albinCuriel/LineFollower/parcours/readme.md

# Parcours

Testparcours van de docent. De PDF's zijn op ware grootte: afdrukken en aan elkaar plakken om thuis te testen.

| Bestand | Inhoud |
|---|---|
| [parcours1.pdf](parcours1.pdf) | parcours 1 |
| [parcours2.pdf](parcours2.pdf) | parcours 2 |
| [parcours3.pdf](parcours3.pdf) | parcours 3 |
| [parcours3.svg](parcours3.svg) | parcours 3 als vectorbestand, gebruikt voor de snelheidssimulatie in [onderdelenkeuze.md](../ontwerpkeuzes/onderdelenkeuze.md) |
| [testbaan.pdf](testbaan.pdf) | korte testbaan voor sensor- en PID-testen |

Parcours 3 is ±7,0 m lang (gemeten in de [simulatie](../simulatie/readme.md)) en bestaat grotendeels uit rechte stukken. Alle bochten hebben een straal van ±10 cm.
Volgens de specificaties is de lijn 15 mm breed, rijdt de robot op kruispunten rechtdoor en zijn onderbrekingen korter dan 10 mm.
