albinCuriel/LineFollower/technische tekeningen/elektronisch/kabels/readme.md

# Kabels

Alles wat niet op de gaatjesprint zelf ligt: de batterij-pigtail, de 2 motorkabels (motor + encoder) en de 11 draadjes van de sensor. De gaten (D17, O2, W46, ...) zijn dezelfde als in het [bekabelingsplan](../bekabelingsplan.pdf).

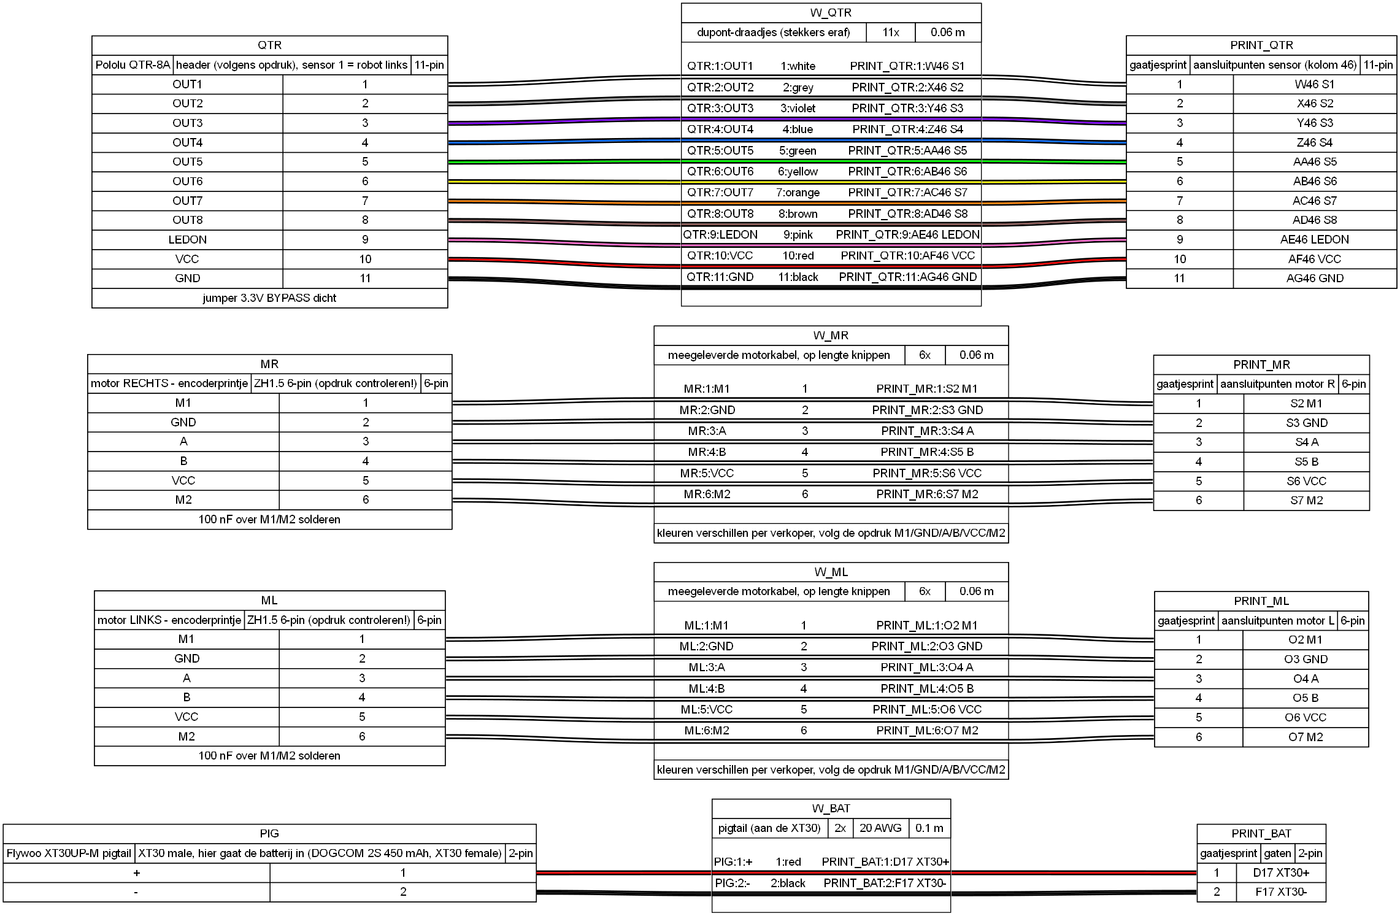
[picture p5: technische tekeningen/elektronisch/kabels/kabels.png]
kabels


| Bestand | Inhoud |
|---|---|
| [kabels.yml](kabels.yml) | beschrijving van de kabels (bron) |
| [kabels.png](kabels.png) / [kabels.svg](kabels.svg) | tekening |
| [kabels.html](kabels.html) | tekening + stuklijst samen |
| [kabels.bom.tsv](kabels.bom.tsv) | stuklijst van de kabels |

Gemaakt met [WireViz](https://github.com/wireviz/WireViz) + [Graphviz](https://graphviz.org):
```
wireviz kabels.yml
```
