albinCuriel/LineFollower/code/basis/basis/readme.md

# basis (sketchmap)

Arduino-sketch van het basisprogramma. Uitleg: [../readme.md](../readme.md).

```
arduino-cli compile --fqbn esp32:esp32:esp32s3 --library ../../lib/lf_core --library ../../lib/lf_esp32 .
```
