albinCuriel/LineFollower/code/finaal/linefollower/readme.md

# linefollower (sketchmap)

Arduino-sketch van de finale firmware. Uitleg en commando's: [../readme.md](../readme.md).

```
arduino-cli compile --fqbn esp32:esp32:esp32s3 --library ../../lib/lf_core --library ../../lib/lf_esp32 .
```
