albinCuriel/LineFollower/technische tekeningen/mechanisch/3d/readme.md

# 3D-model

Gemaakt door [model_linefollower.py](../model_linefollower.py). Assen: X = rijrichting, Y = links, Z = omhoog. Oorsprong = midden wielas op de grond. Eenheid: mm.

| Bestand | Inhoud |
|---|---|
| `linefollower_assembly.step` | volledige samenstelling, te openen in SOLIDWORKS, Fusion 360, FreeCAD of KiCad |
| `*.stl` | elk onderdeel apart. Klik op een STL op GitHub om hem in 3D te bekijken en te draaien |

| STL | Onderdeel |
|---|---|
| [gaatjesprint.stl](gaatjesprint.stl) | chassis 120 × 90 × 1,6 |
| [ESP32-S3_devkit.stl](ESP32-S3_devkit.stl) | ESP32-S3 devkit met pinnen |
| [QTR-8A.stl](QTR-8A.stl) | sensorarray, sensoren naar beneden |
| [M2_bevestiging_sensor.stl](M2_bevestiging_sensor.stl) | 2× M2×25 voor de sensorhoogte |
| [TB6612FNG.stl](TB6612FNG.stl) | H-brug |
| [buck_CN3903_3V3.stl](buck_CN3903_3V3.stl) | 3,3 V-regelaar |
| [LiPo_2S_450mAh.stl](LiPo_2S_450mAh.stl) | batterij |
| [XT30.stl](XT30.stl) | batterijconnector |
| [motor_links.stl](motor_links.stl), [motor_rechts.stl](motor_rechts.stl) | N20 10:1 met encoder |
| [beugel_links.stl](beugel_links.stl), [beugel_rechts.stl](beugel_rechts.stl) | Pololu motorbeugels |
| [wiel_links.stl](wiel_links.stl), [wiel_rechts.stl](wiel_rechts.stl) | Pololu wiel 32×7 |
| [ball_caster.stl](ball_caster.stl) | Pololu ball caster 3/8″ |
| [caster_afstandsstukken.stl](caster_afstandsstukken.stl) | afstandsringen + moeren tot 12,4 mm |
| [aan_uit_schakelaar.stl](aan_uit_schakelaar.stl) | SS12D00 |
| [start_stop_knop.stl](start_stop_knop.stl) | drukknop 6×6 |
| [elco_100uF.stl](elco_100uF.stl) | C1 en C2 |
| [spoiler.stl](spoiler.stl), [spoiler_bouten.stl](spoiler_bouten.stl) | spoiler uit het afgezaagde stuk print, op 2× M3×30 |

Niets wordt 3D-geprint. Het model dient om te controleren of alles past en om de tekeningen te maken.
