albinCuriel/LineFollower/code/proof of concepts/hbridge/poc_hbridge/readme.md

# poc_hbridge

Arduino-sketchmap. Open `poc_hbridge.ino` in de Arduino IDE of compileer met

```
arduino-cli compile --fqbn esp32:esp32:esp32s3 .
```

`board.h` is een kopie van [code/board.h](../../../board.h) (Arduino neemt enkel bestanden uit de eigen sketchmap mee).
Uitleg en testresultaat: [readme van deze proof of concept](../readme.md).
