albinCuriel/LineFollower/images/readme.md

# Images

Foto's van de robot tijdens en na de bouw. Ze komen hier zodra de onderdelen geleverd en gemonteerd zijn.

| Bestand | Inhoud |
|---|---|
| `empty.png` | plaatshouder uit de template |

De renders van het 3D-model staan in [technische tekeningen/mechanisch](../technische%20tekeningen/mechanisch/readme.md).
