albinCuriel/LineFollower/technische tekeningen/elektronisch/bekabelingsplan_boormal_1op1.png

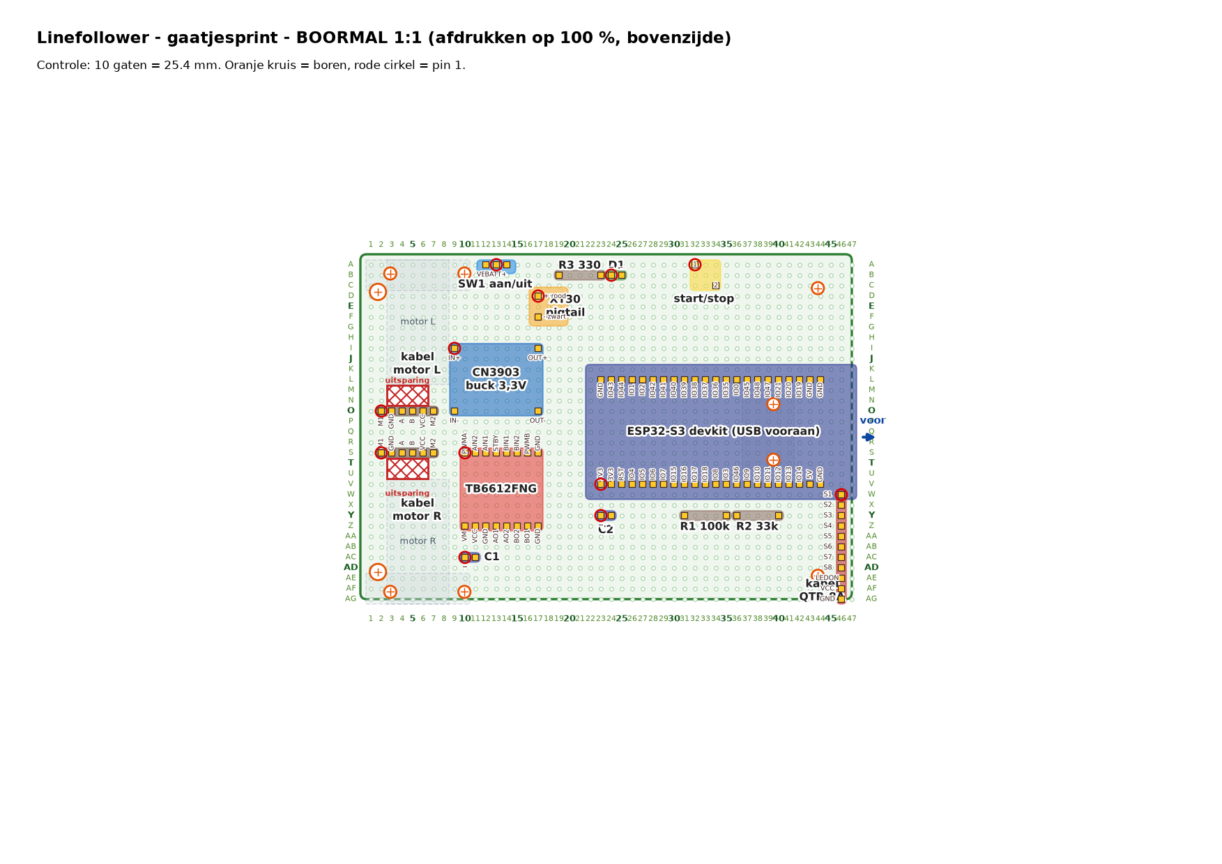
technische tekeningen/elektronisch/bekabelingsplan_boormal_1op1.png
