albinCuriel/LineFollower/technische tekeningen/elektronisch/bekabelingsplan_p08_alles.png

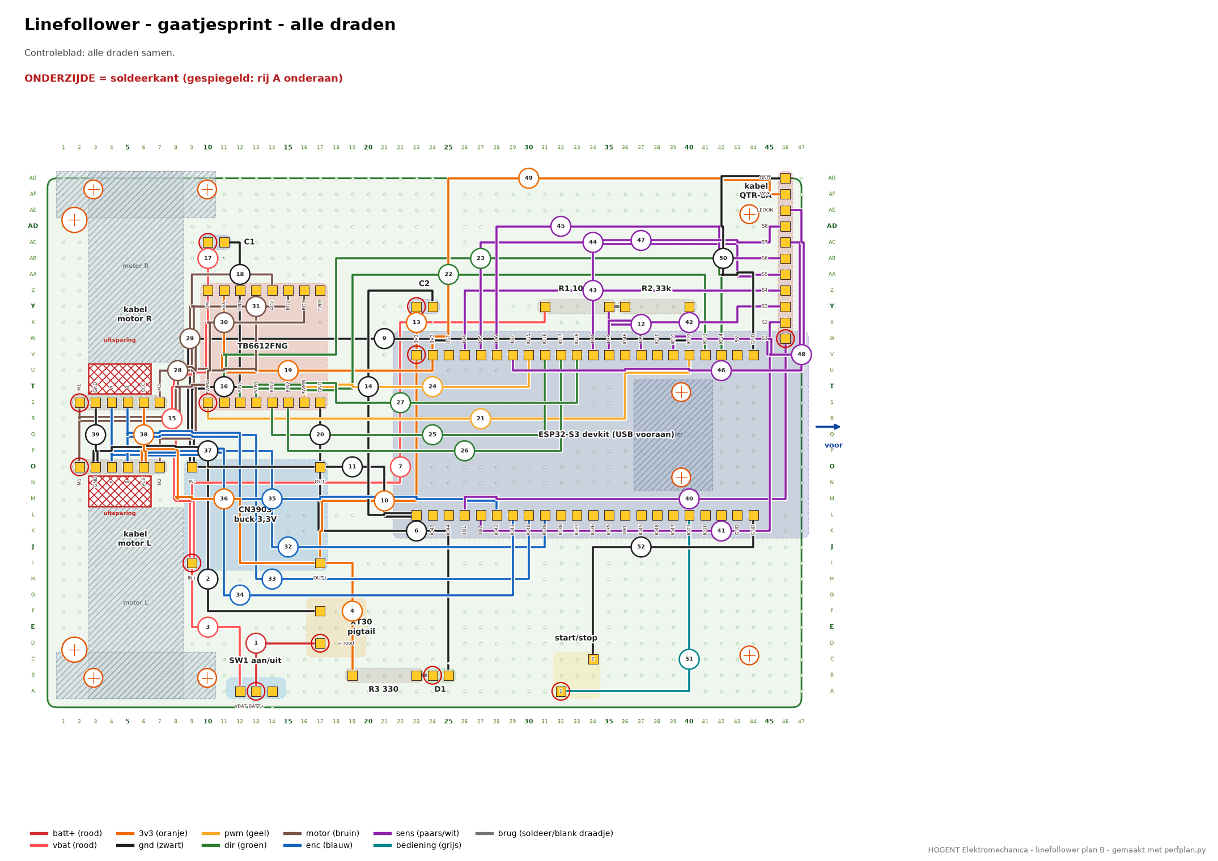
technische tekeningen/elektronisch/bekabelingsplan_p08_alles.png
