albinCuriel/LineFollower/technische tekeningen/mechanisch/3d_iso_achter_rechts.png

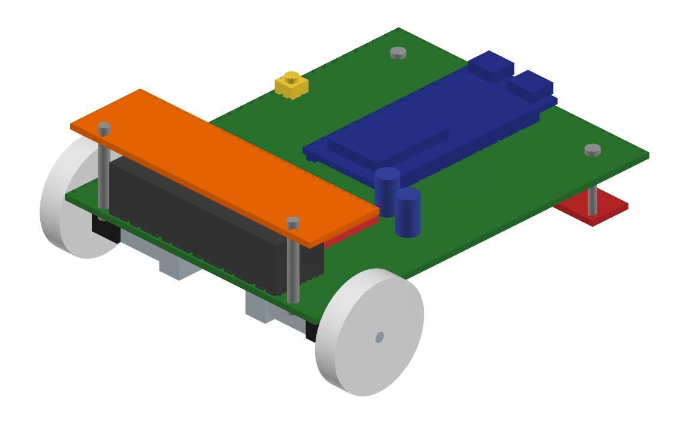
technische tekeningen/mechanisch/3d_iso_achter_rechts.png
