albinCuriel/LineFollower/technische tekeningen/mechanisch/3d_iso_onder.png

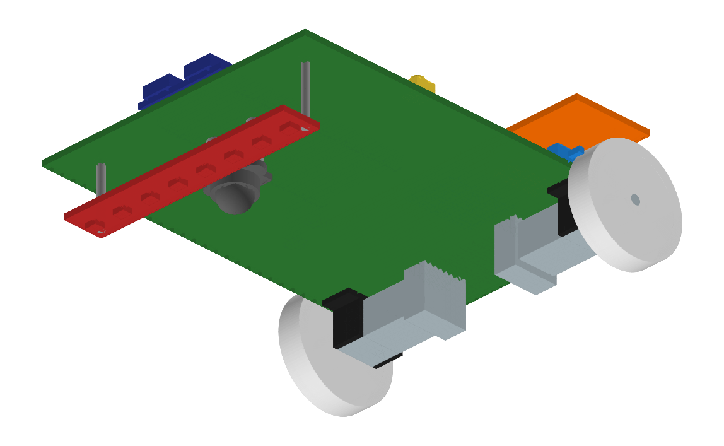
technische tekeningen/mechanisch/3d_iso_onder.png
