albinCuriel/LineFollower/technische tekeningen/mechanisch/3d/linefollower_assembly.step

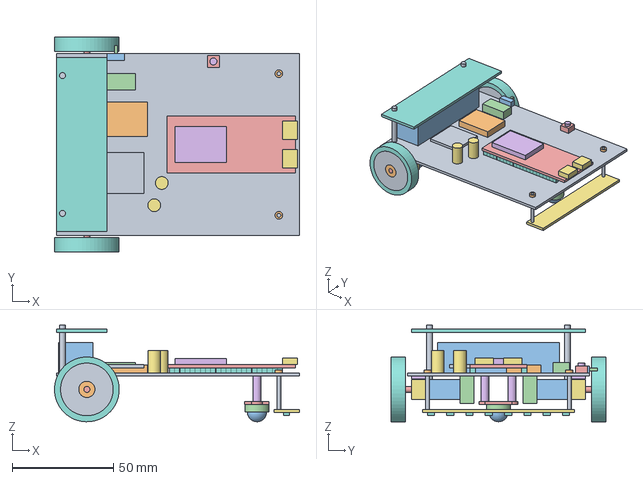
[picture p16: CAD file, 2026-10-19]
technische tekeningen/mechanisch/3d/linefollower_assembly.step
121.0 x 106.0 x 47.7 mm
