albinCuriel/LineFollower/technische tekeningen/mechanisch/3d/caster_afstandsstukken.stl

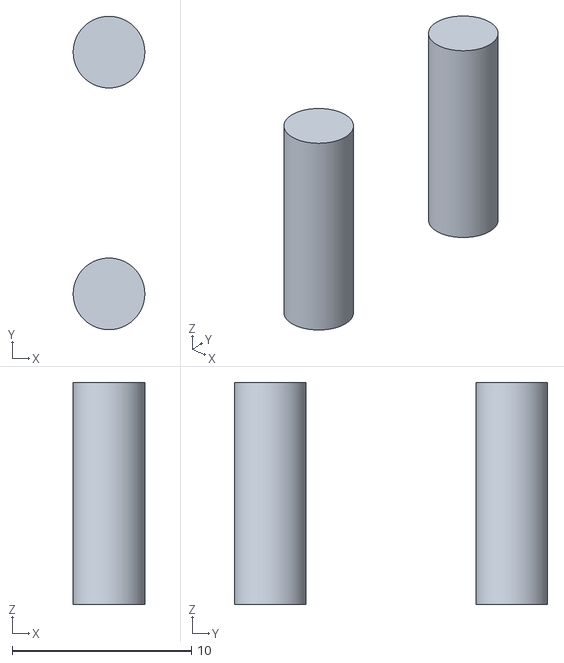
[picture p17: CAD file, 2026-10-19]
technische tekeningen/mechanisch/3d/caster_afstandsstukken.stl
4.00 x 17.5 x 12.4
