albinCuriel/LineFollower/technische tekeningen/mechanisch/3d/ball_caster.stl

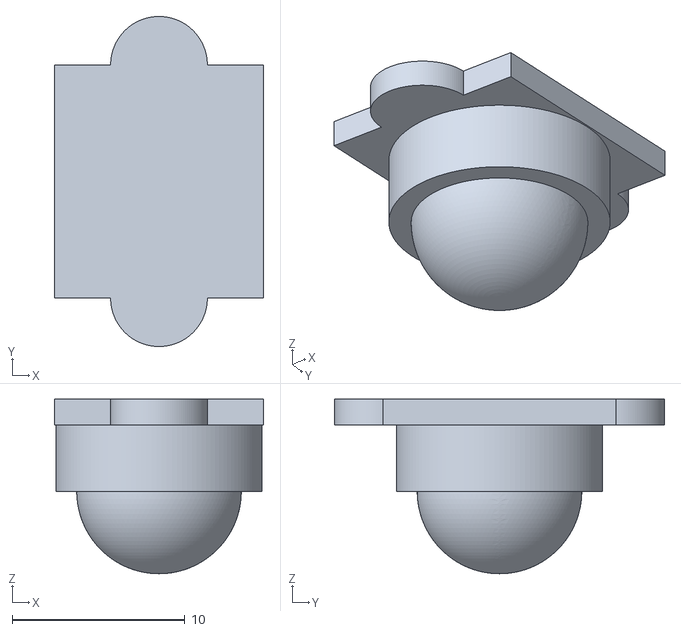
[picture p18: CAD file, 2026-10-19]
technische tekeningen/mechanisch/3d/ball_caster.stl
12.1 x 19.1 x 10.1
