albinCuriel/LineFollower/technische tekeningen/mechanisch/3d/aan_uit_schakelaar.stl

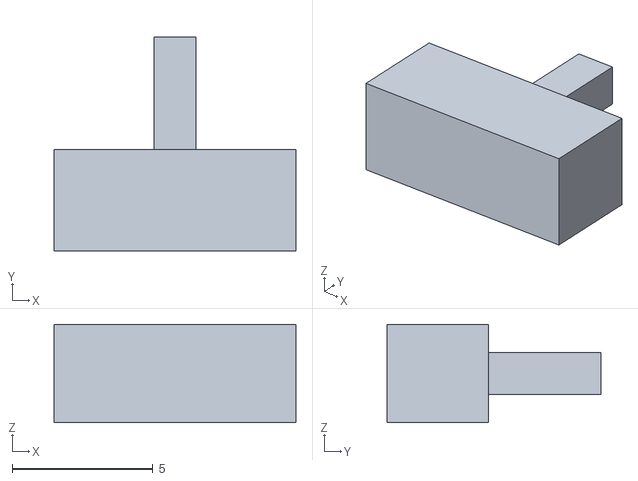
[picture p19: CAD file, 2026-10-19]
technische tekeningen/mechanisch/3d/aan_uit_schakelaar.stl
8.60 x 7.60 x 3.50
