albinCuriel/LineFollower/technische tekeningen/mechanisch/3d/gaatjesprint.stl

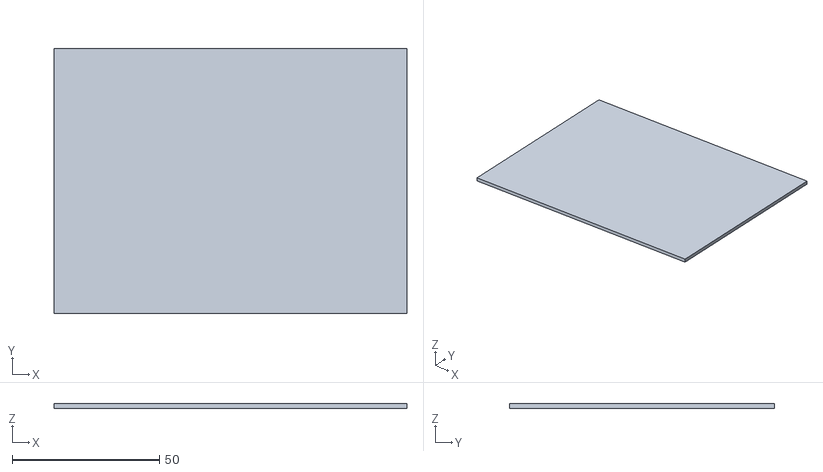
[picture p20: CAD file, 2026-10-19]
technische tekeningen/mechanisch/3d/gaatjesprint.stl
120.0 x 90.0 x 1.60
