albinCuriel/LineFollower/technische tekeningen/mechanisch/3d/spoiler_bouten.stl

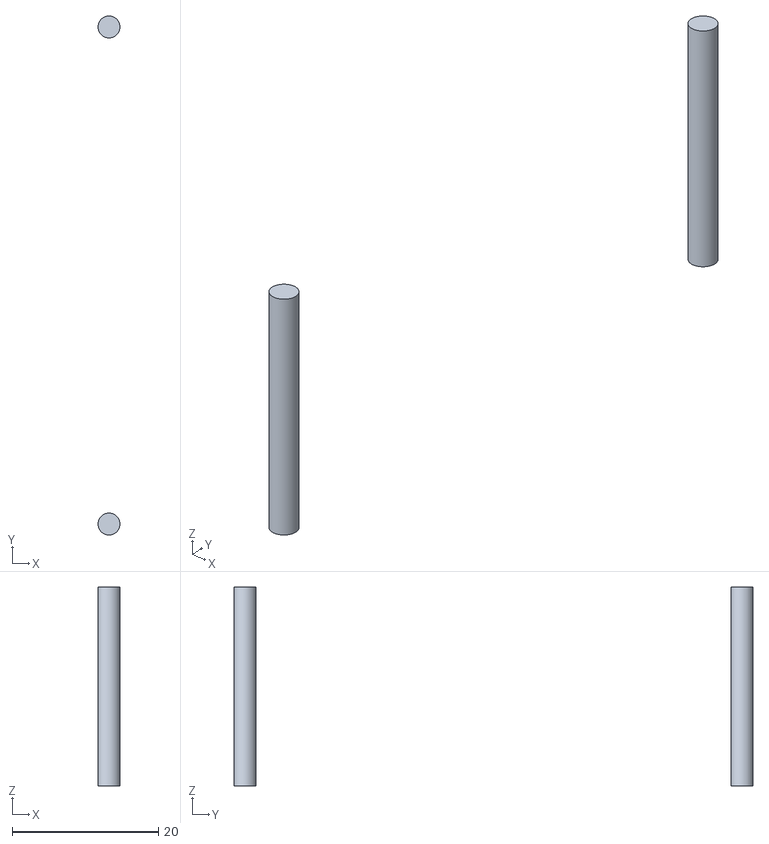
[picture p21: CAD file, 2026-10-19]
technische tekeningen/mechanisch/3d/spoiler_bouten.stl
3.00 x 71.0 x 27.2
