albinCuriel/LineFollower/technische tekeningen/mechanisch/3d/motor_links.stl

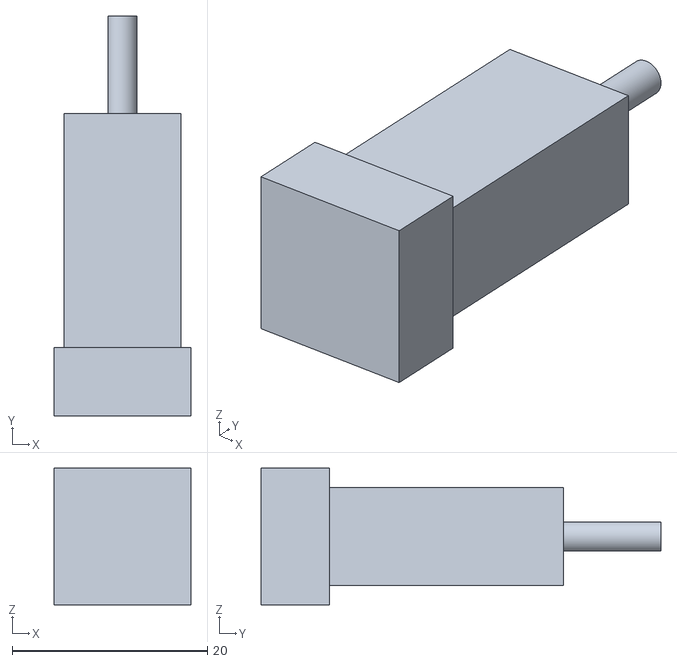
[picture p22: CAD file, 2026-10-19]
technische tekeningen/mechanisch/3d/motor_links.stl
14.0 x 41.0 x 14.0
