albinCuriel/LineFollower/technische tekeningen/mechanisch/3d/ESP32-S3_devkit.stl

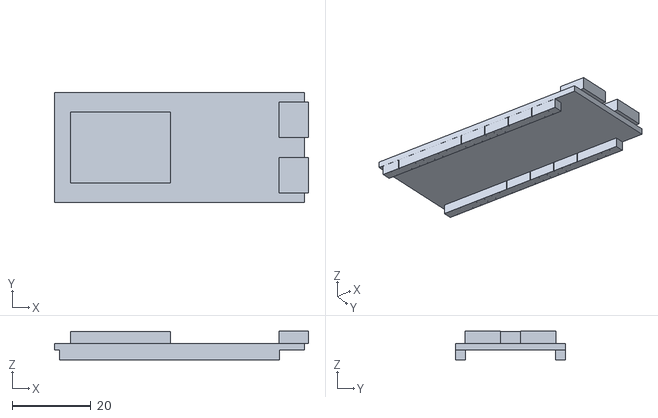
[picture p23: CAD file, 2026-10-19]
technische tekeningen/mechanisch/3d/ESP32-S3_devkit.stl
64.5 x 28.0 x 7.30
