albinCuriel/LineFollower/technische tekeningen/mechanisch/3d/LiPo_2S_450mAh.stl

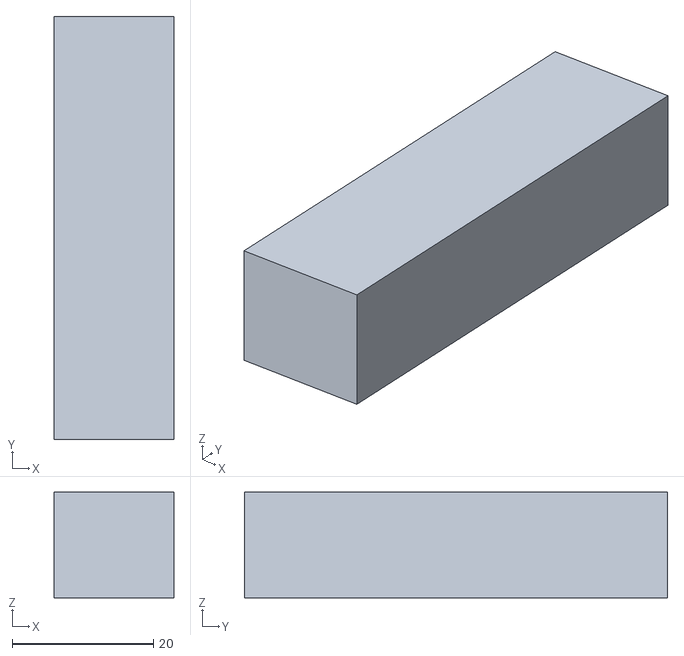
[picture p24: CAD file, 2026-10-19]
technische tekeningen/mechanisch/3d/LiPo_2S_450mAh.stl
17.0 x 60.0 x 15.0
