albinCuriel/LineFollower/technische tekeningen/mechanisch/3d/beugel_links.stl

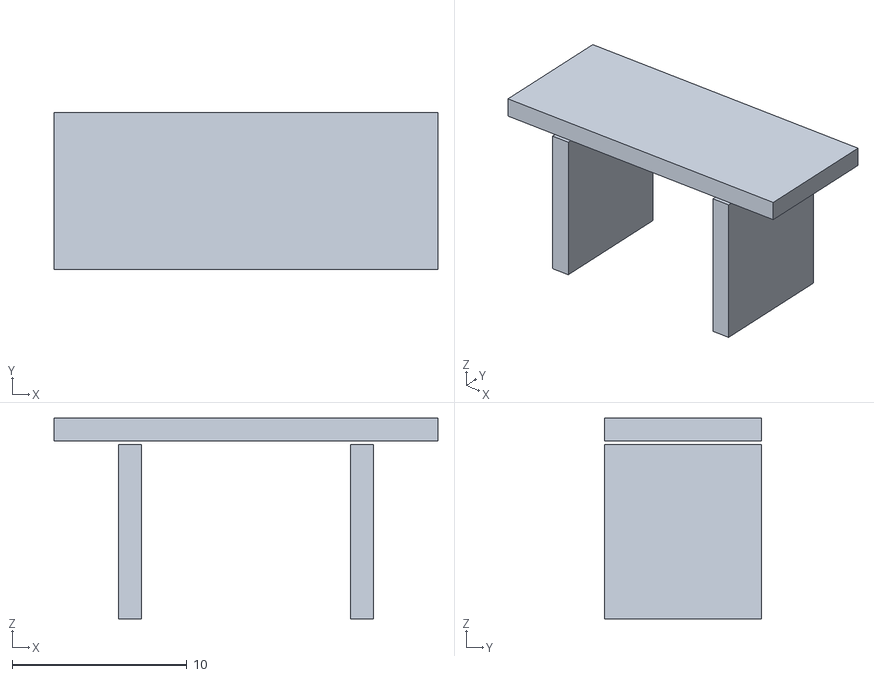
[picture p25: CAD file, 2026-10-19]
technische tekeningen/mechanisch/3d/beugel_links.stl
22.0 x 9.00 x 11.5
