albinCuriel/LineFollower/technische tekeningen/mechanisch/3d/spoiler.stl

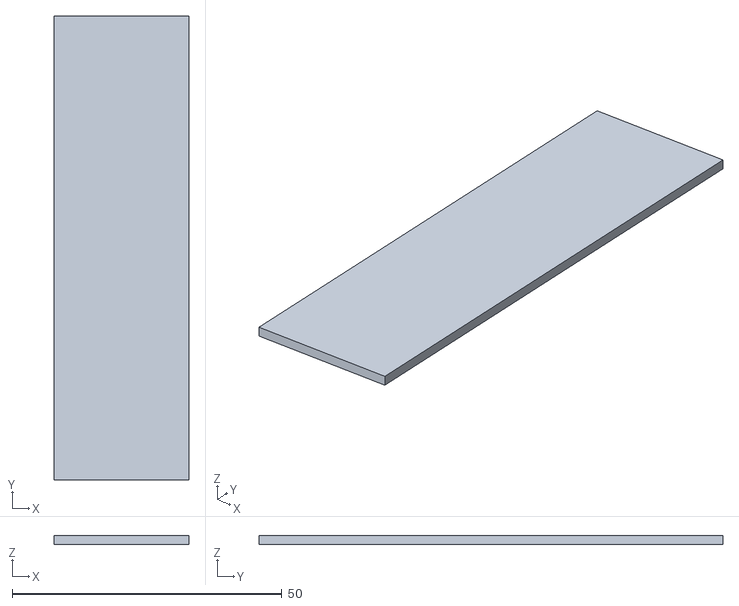
[picture p26: CAD file, 2026-10-19]
technische tekeningen/mechanisch/3d/spoiler.stl
25.0 x 86.0 x 1.60
