albinCuriel/LineFollower/technische tekeningen/mechanisch/3d/wiel_links.stl

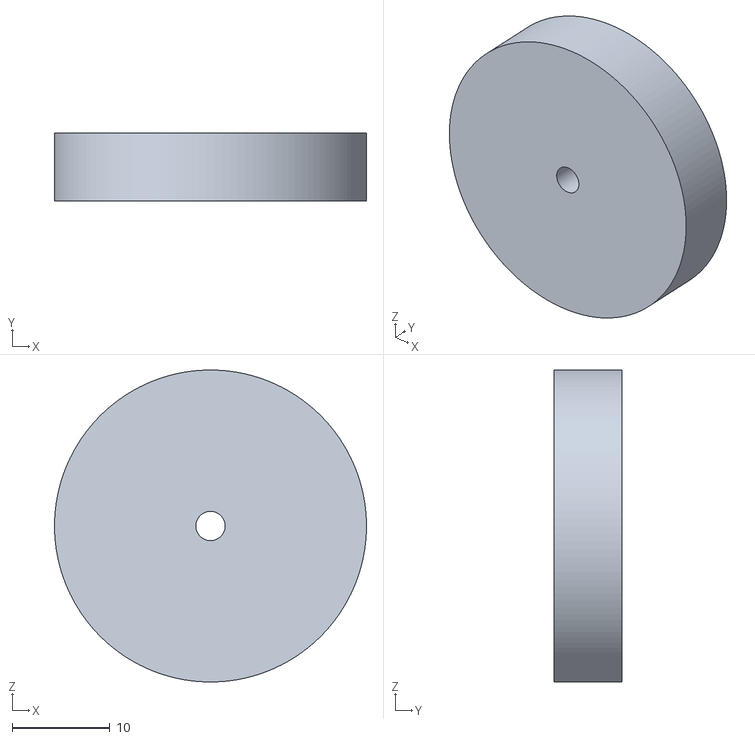
[picture p27: CAD file, 2026-10-19]
technische tekeningen/mechanisch/3d/wiel_links.stl
32.0 x 7.00 x 32.0
