albinCuriel/LineFollower/technische tekeningen/mechanisch/3d/QTR-8A.stl

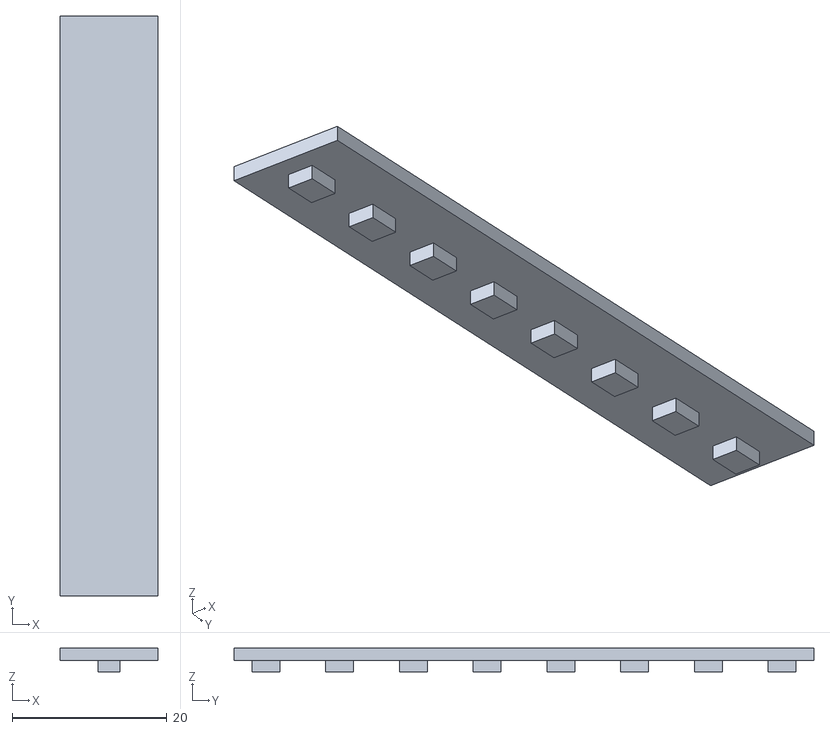
[picture p28: CAD file, 2026-10-19]
technische tekeningen/mechanisch/3d/QTR-8A.stl
12.7 x 74.9 x 3.07
