albinCuriel/LineFollower/technische tekeningen/mechanisch/3d/start_stop_knop.stl

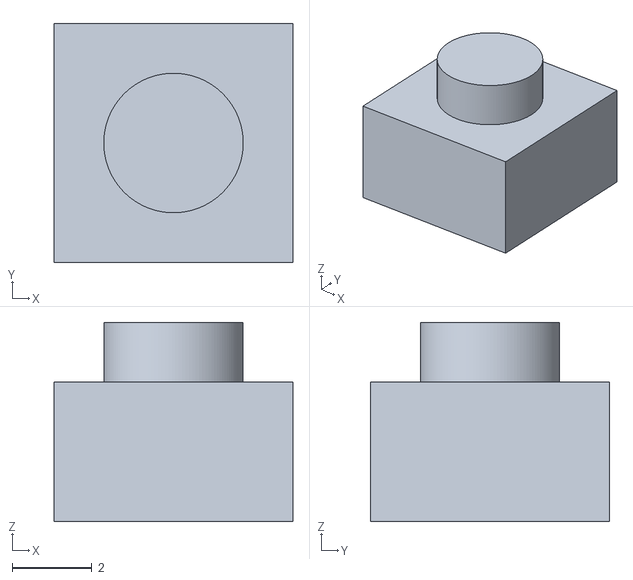
[picture p29: CAD file, 2026-10-19]
technische tekeningen/mechanisch/3d/start_stop_knop.stl
6.00 x 6.00 x 5.00
