albinCuriel/LineFollower/technische tekeningen/mechanisch/3d/M2_bevestiging_sensor.stl

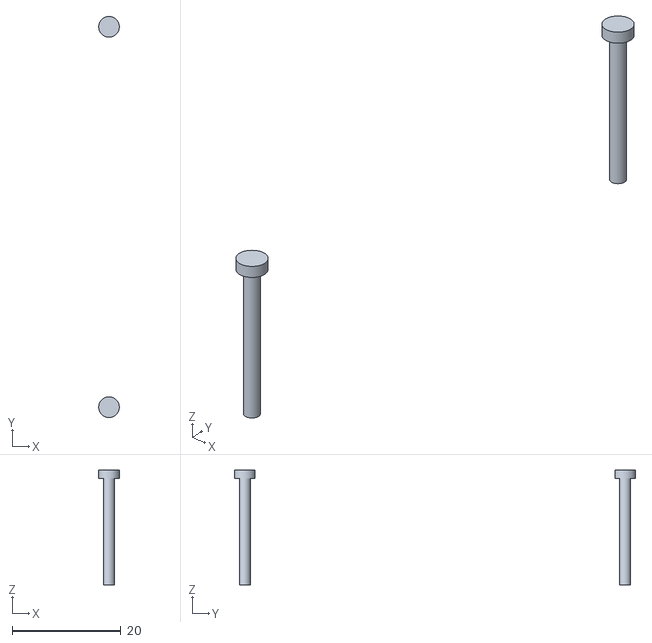
[picture p30: CAD file, 2026-10-19]
technische tekeningen/mechanisch/3d/M2_bevestiging_sensor.stl
3.80 x 73.7 x 21.1
