albinCuriel/LineFollower/technische tekeningen/mechanisch/3d/TB6612FNG.stl

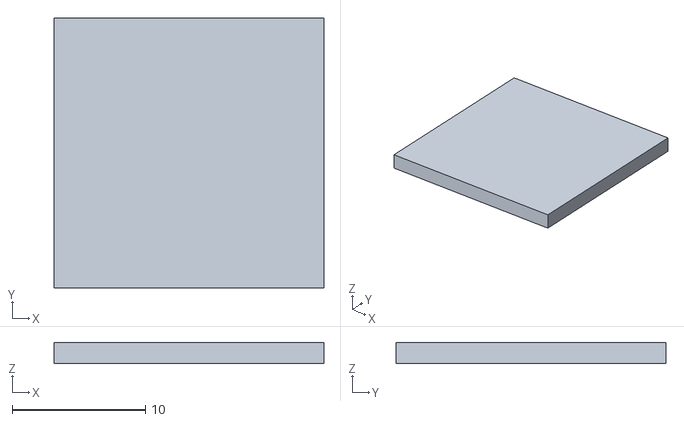
[picture p31: CAD file, 2026-10-19]
technische tekeningen/mechanisch/3d/TB6612FNG.stl
20.3 x 20.3 x 1.60
