albinCuriel/LineFollower/technische tekeningen/mechanisch/3d/XT30.stl

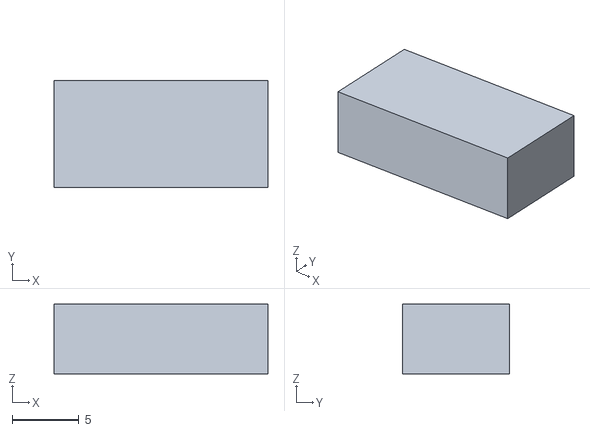
[picture p32: CAD file, 2026-10-19]
technische tekeningen/mechanisch/3d/XT30.stl
16.0 x 8.00 x 5.20
