albinCuriel/LineFollower/technische tekeningen/mechanisch/3d/buck_CN3903_3V3.stl

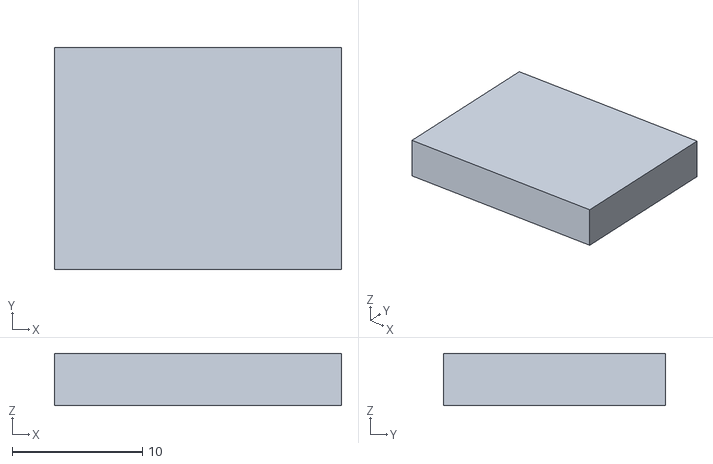
[picture p33: CAD file, 2026-10-19]
technische tekeningen/mechanisch/3d/buck_CN3903_3V3.stl
22.0 x 17.0 x 4.00
