albinCuriel/LineFollower/technische tekeningen/mechanisch/3d/elco_100uF.stl

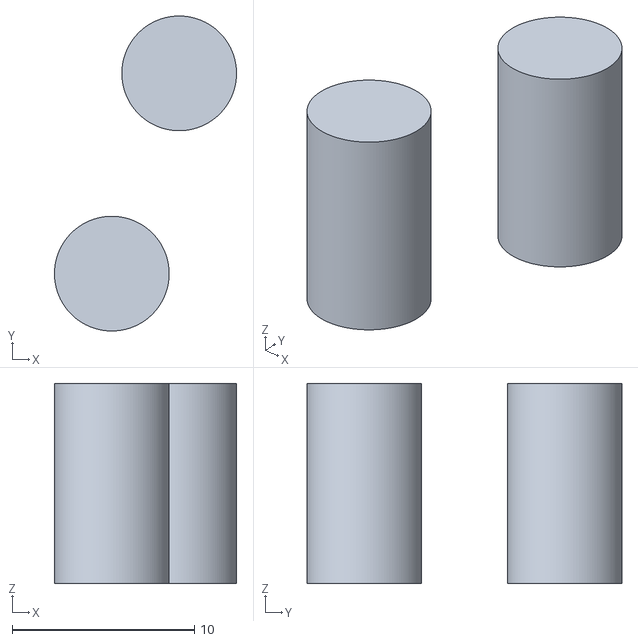
[picture p34: CAD file, 2026-10-19]
technische tekeningen/mechanisch/3d/elco_100uF.stl
10.0 x 17.3 x 11.0
