albinCuriel/LineFollower/(list of files, cad)

Other CAD files:
technische tekeningen/mechanisch/3d/motor_rechts.stl
technische tekeningen/mechanisch/3d/wiel_rechts.stl
technische tekeningen/mechanisch/3d/beugel_rechts.stl
