albinCuriel/LineFollower/simulatie/resultaat.png

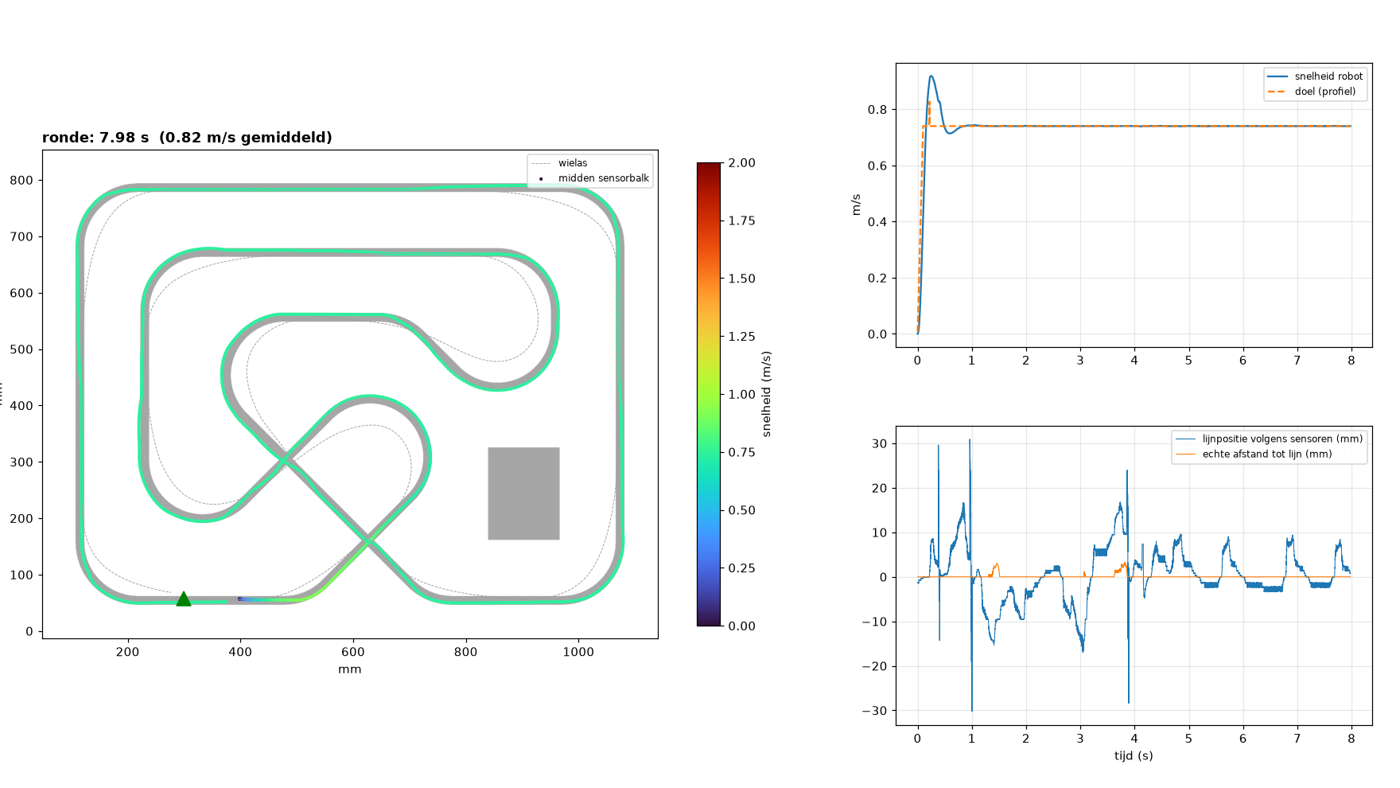
simulatie/resultaat.png
