albinCuriel/LineFollower/technische tekeningen/elektronisch/bekabelingsplan.pdf

## Onderdeel · referentiepin -> gat

# Linefollower - gaatjesprint - plaatsing

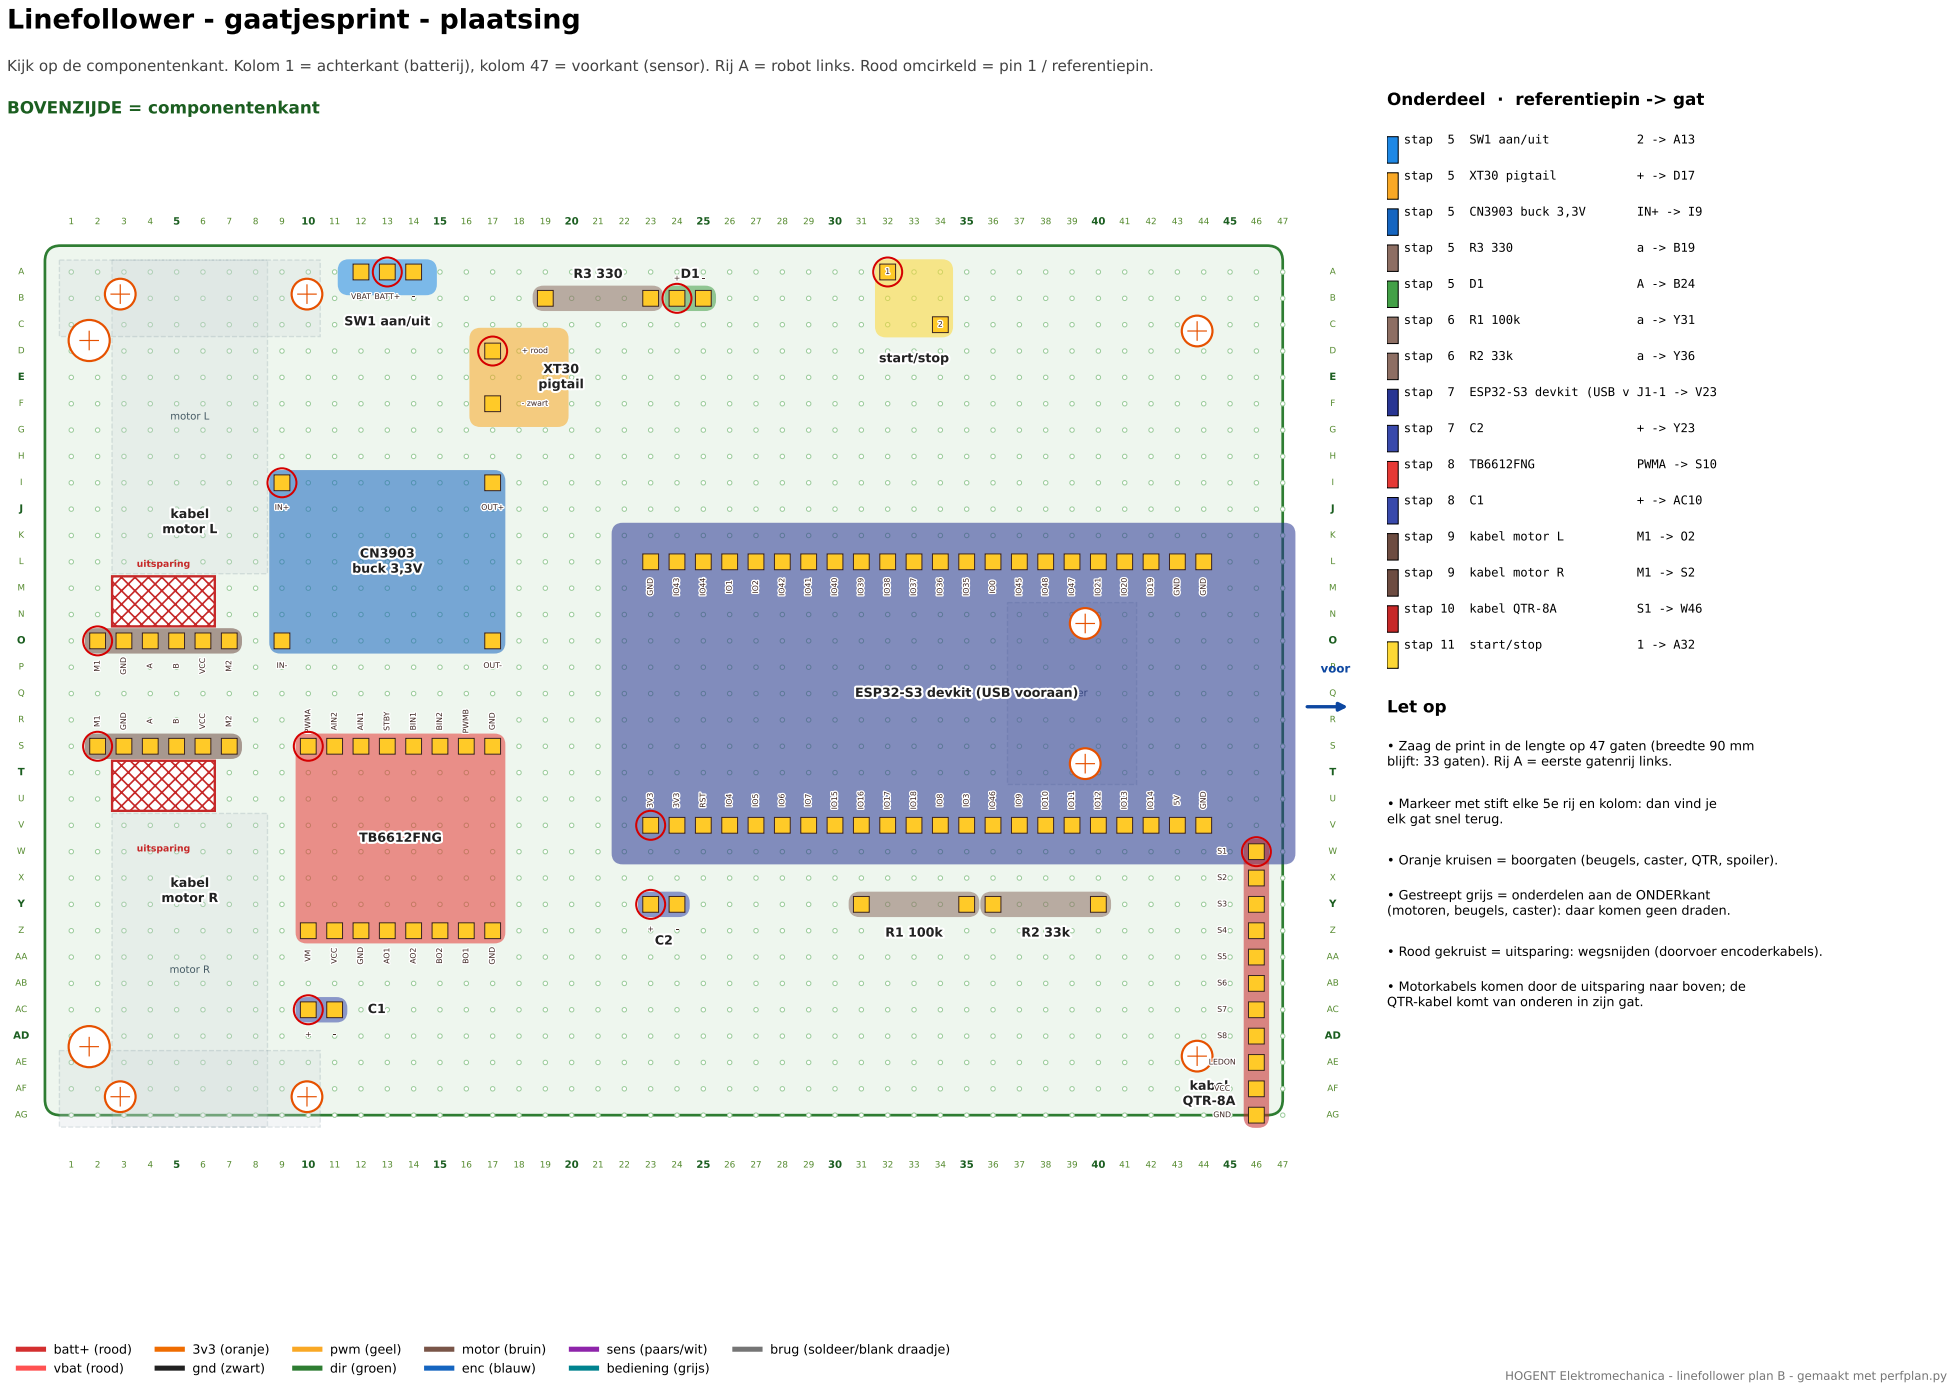
[picture p37: page 1]

Kijk op de componentenkant. Kolom 1 = achterkant (batterij), kolom 47 = voorkant (sensor). Rij A = robot links. Rood omcirkeld = pin 1 / referentiepin.

• Zaag de print in de lengte op 47 gaten (breedte 90 mm
blijft: 33 gaten). Rij A = eerste gatenrij links.

• Markeer met stift elke 5e rij en kolom: dan vind je
elk gat snel terug.

• Oranje kruisen = boorgaten (beugels, caster, QTR, spoiler).

• Gestreept grijs = onderdelen aan de ONDERkant
(motoren, beugels, caster): daar komen geen draden.

• Rood gekruist = uitsparing: wegsnijden (doorvoer encoderkabels).

• Motorkabels komen door de uitsparing naar boven; de
QTR-kabel komt van onderen in zijn gat.

brug (soldeer/blank draadje)

HOGENT Elektromechanica - linefollower plan B - gemaakt met perfplan.py

## Draden stap 5 (nr gat pin / gat pin lengte)

# Stap 5 - voeding

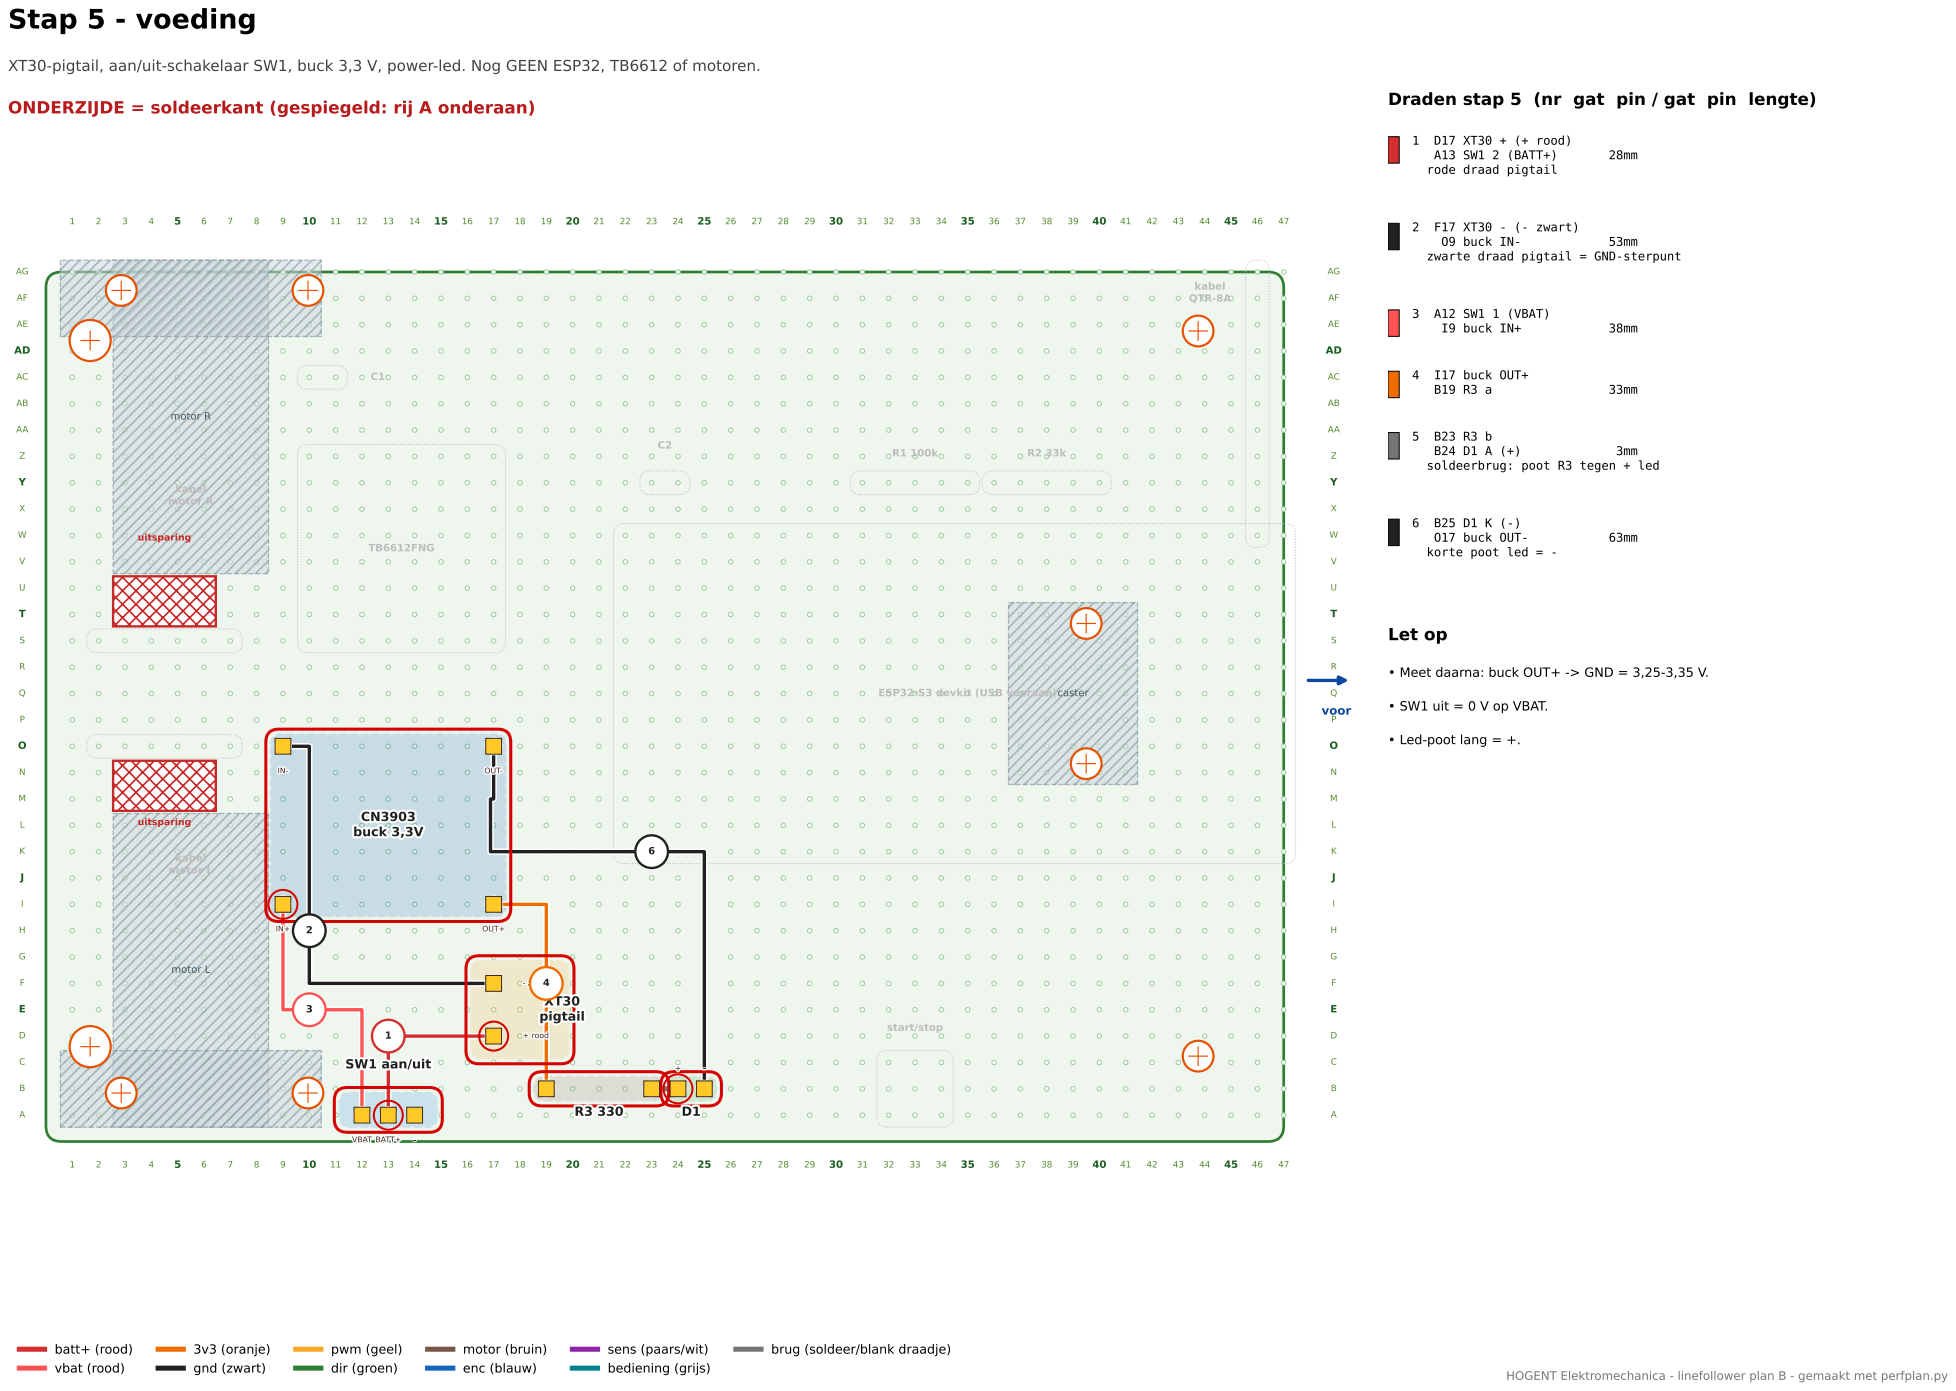
[picture p38: page 2]

XT30-pigtail, aan/uit-schakelaar SW1, buck 3,3 V, power-led. Nog GEEN ESP32, TB6612 of motoren.

ONDERZIJDE = soldeerkant (gespiegeld: rij A onderaan)

zwarte draad pigtail = GND-sterpunt

soldeerbrug: poot R3 tegen + led

• Meet daarna: buck OUT+ -> GND = 3,25-3,35 V.

## Draden stap 6 (nr gat pin / gat pin lengte)

# Stap 6 - batterijmeting

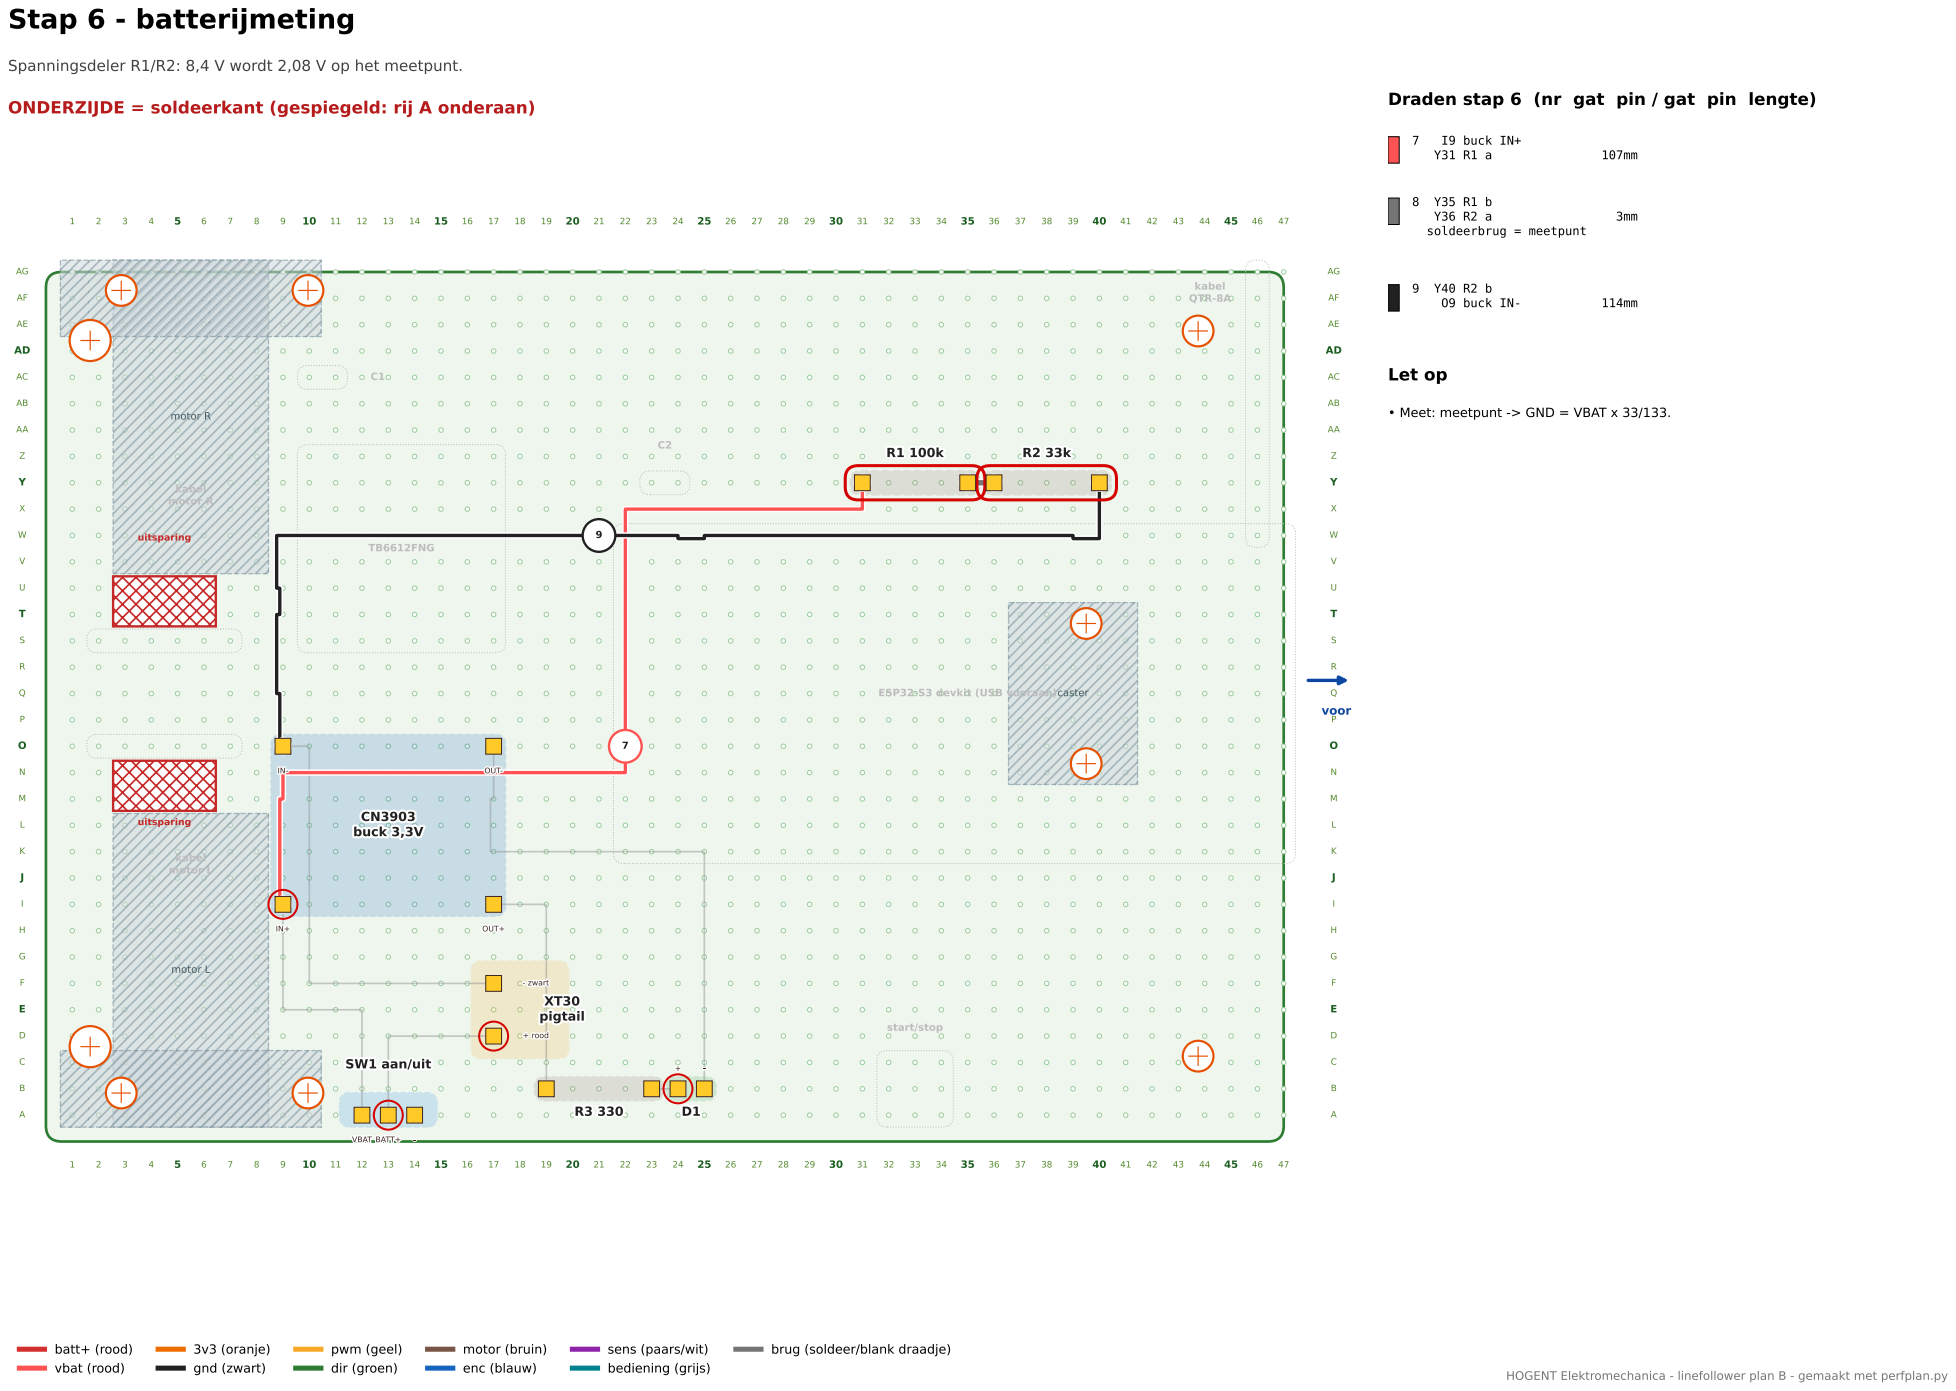
[picture p39: page 3]
motor L; motor R; caster; voor; uitsparing; TB6612FNG; kabel motor L; kabel motor R; kabel QTR-8A; start/stop; I9 buck IN+; soldeerbrug = meetpunt; O9 buck IN-; Let op

Spanningsdeler R1/R2: 8,4 V wordt 2,08 V op het meetpunt.

ONDERZIJDE = soldeerkant (gespiegeld: rij A onderaan)

• Meet: meetpunt -> GND = VBAT x 33/133.

ESP32-S3 devkit (USB vooraan)

## Draden stap 7 (nr gat pin / gat pin lengte)

# Stap 7 - ESP32-S3 devkit

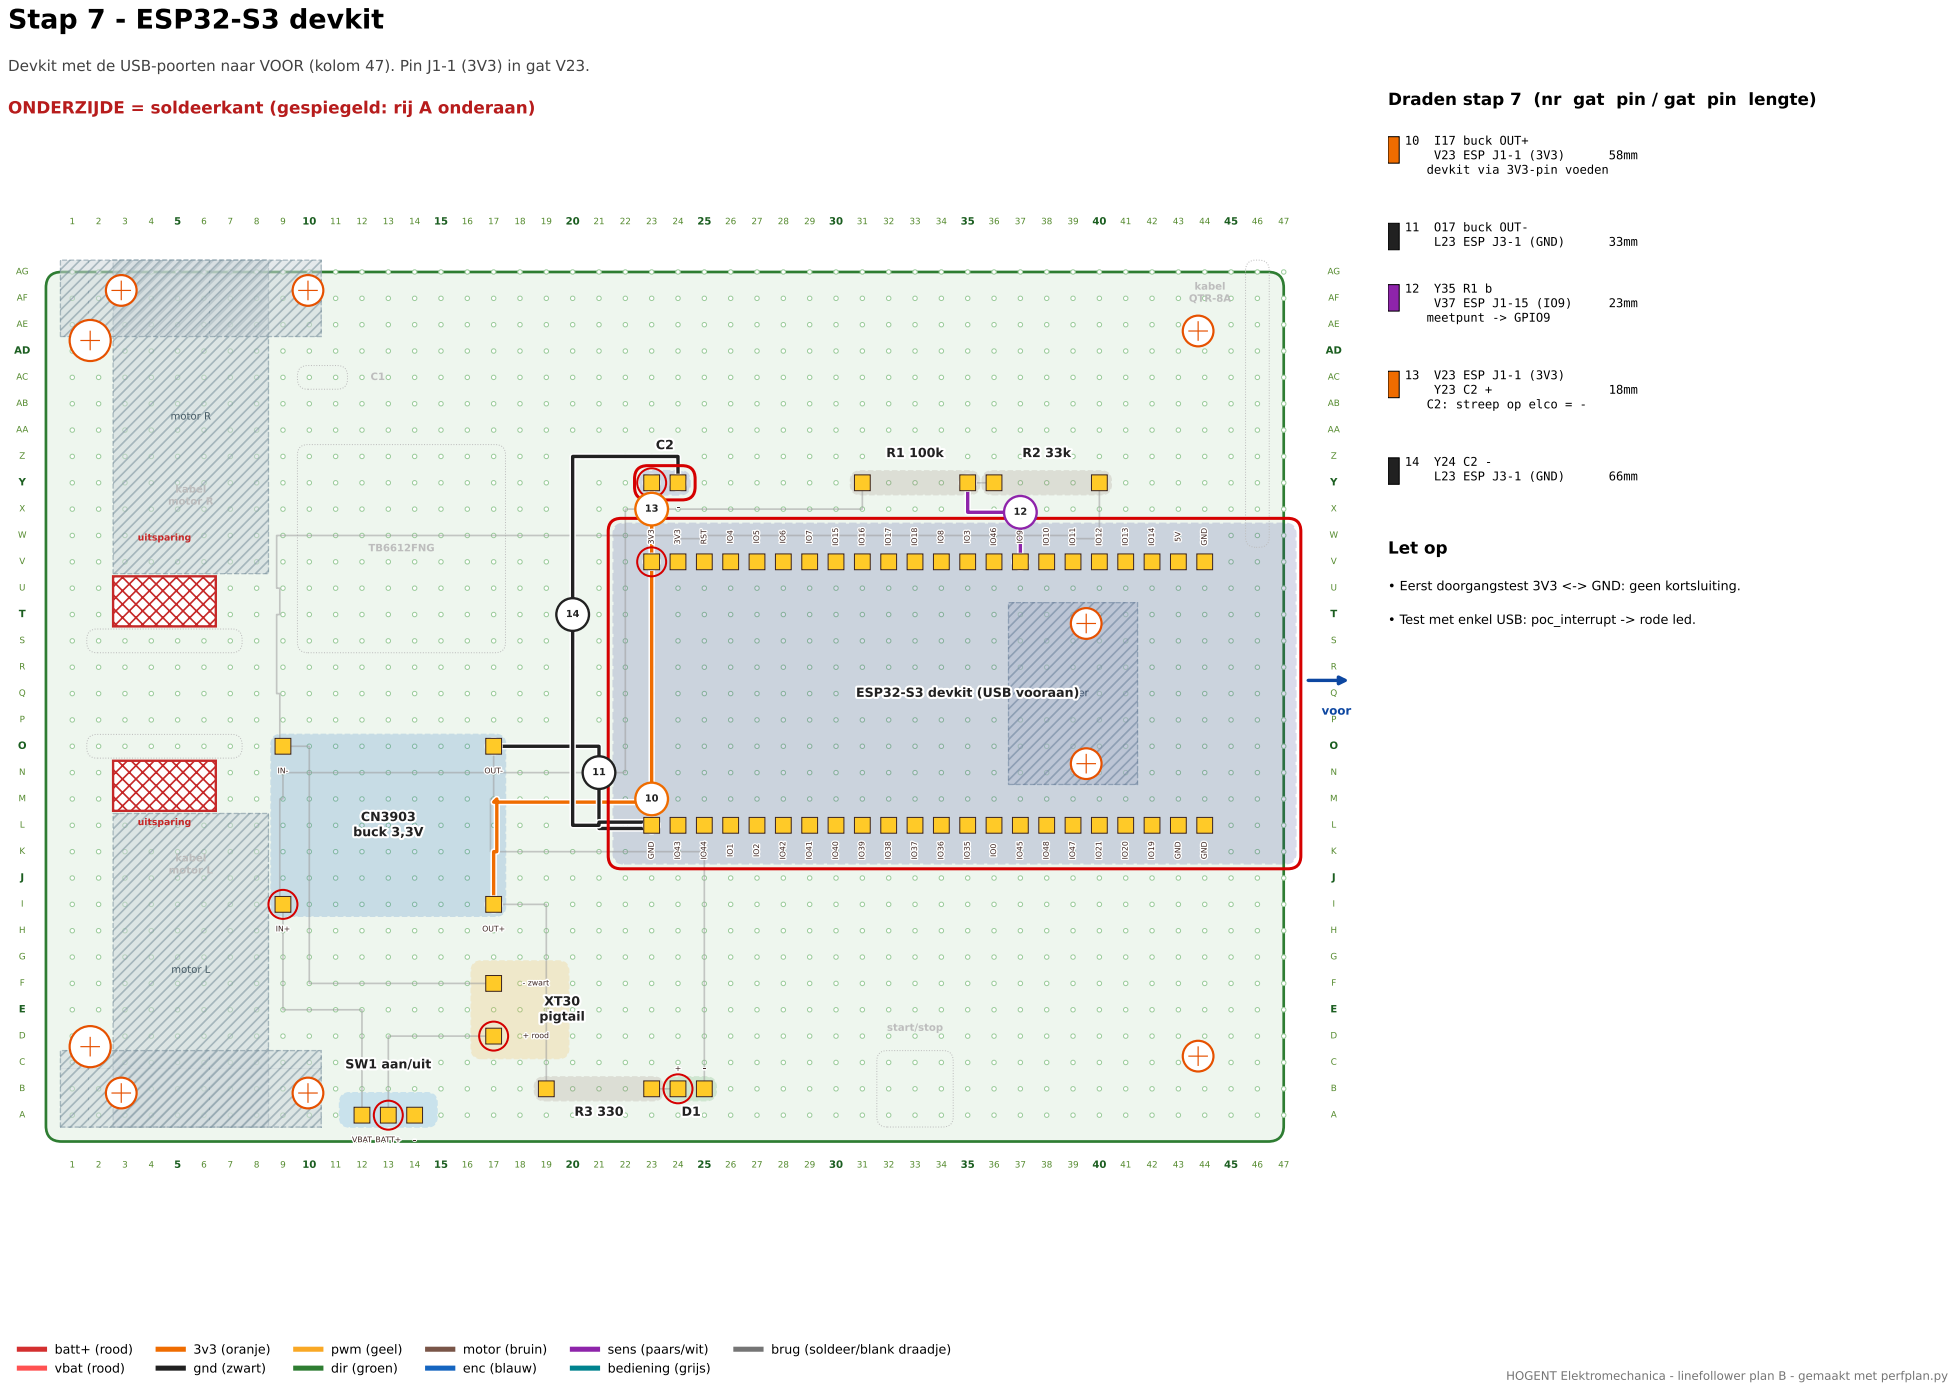
[picture p40: page 4]
motor L; motor R; caster; voor; uitsparing; TB6612FNG; kabel motor L; kabel motor R; kabel QTR-8A; start/stop; I17 buck OUT+; V23 ESP J1-1 (3V3); O17 buck OUT-; L23 ESP J3-1 (GND); V37 ESP J1-15 (IO9); meetpunt -> GPIO9; Let op

Devkit met de USB-poorten naar VOOR (kolom 47). Pin J1-1 (3V3) in gat V23.

ONDERZIJDE = soldeerkant (gespiegeld: rij A onderaan)

devkit via 3V3-pin voeden

C2: streep op elco = -

• Eerst doorgangstest 3V3 <-> GND: geen kortsluiting.

• Test met enkel USB: poc_interrupt -> rode led.

## Draden stap 8 (nr gat pin / gat pin lengte)

# Stap 8 - H-brug TB6612FNG

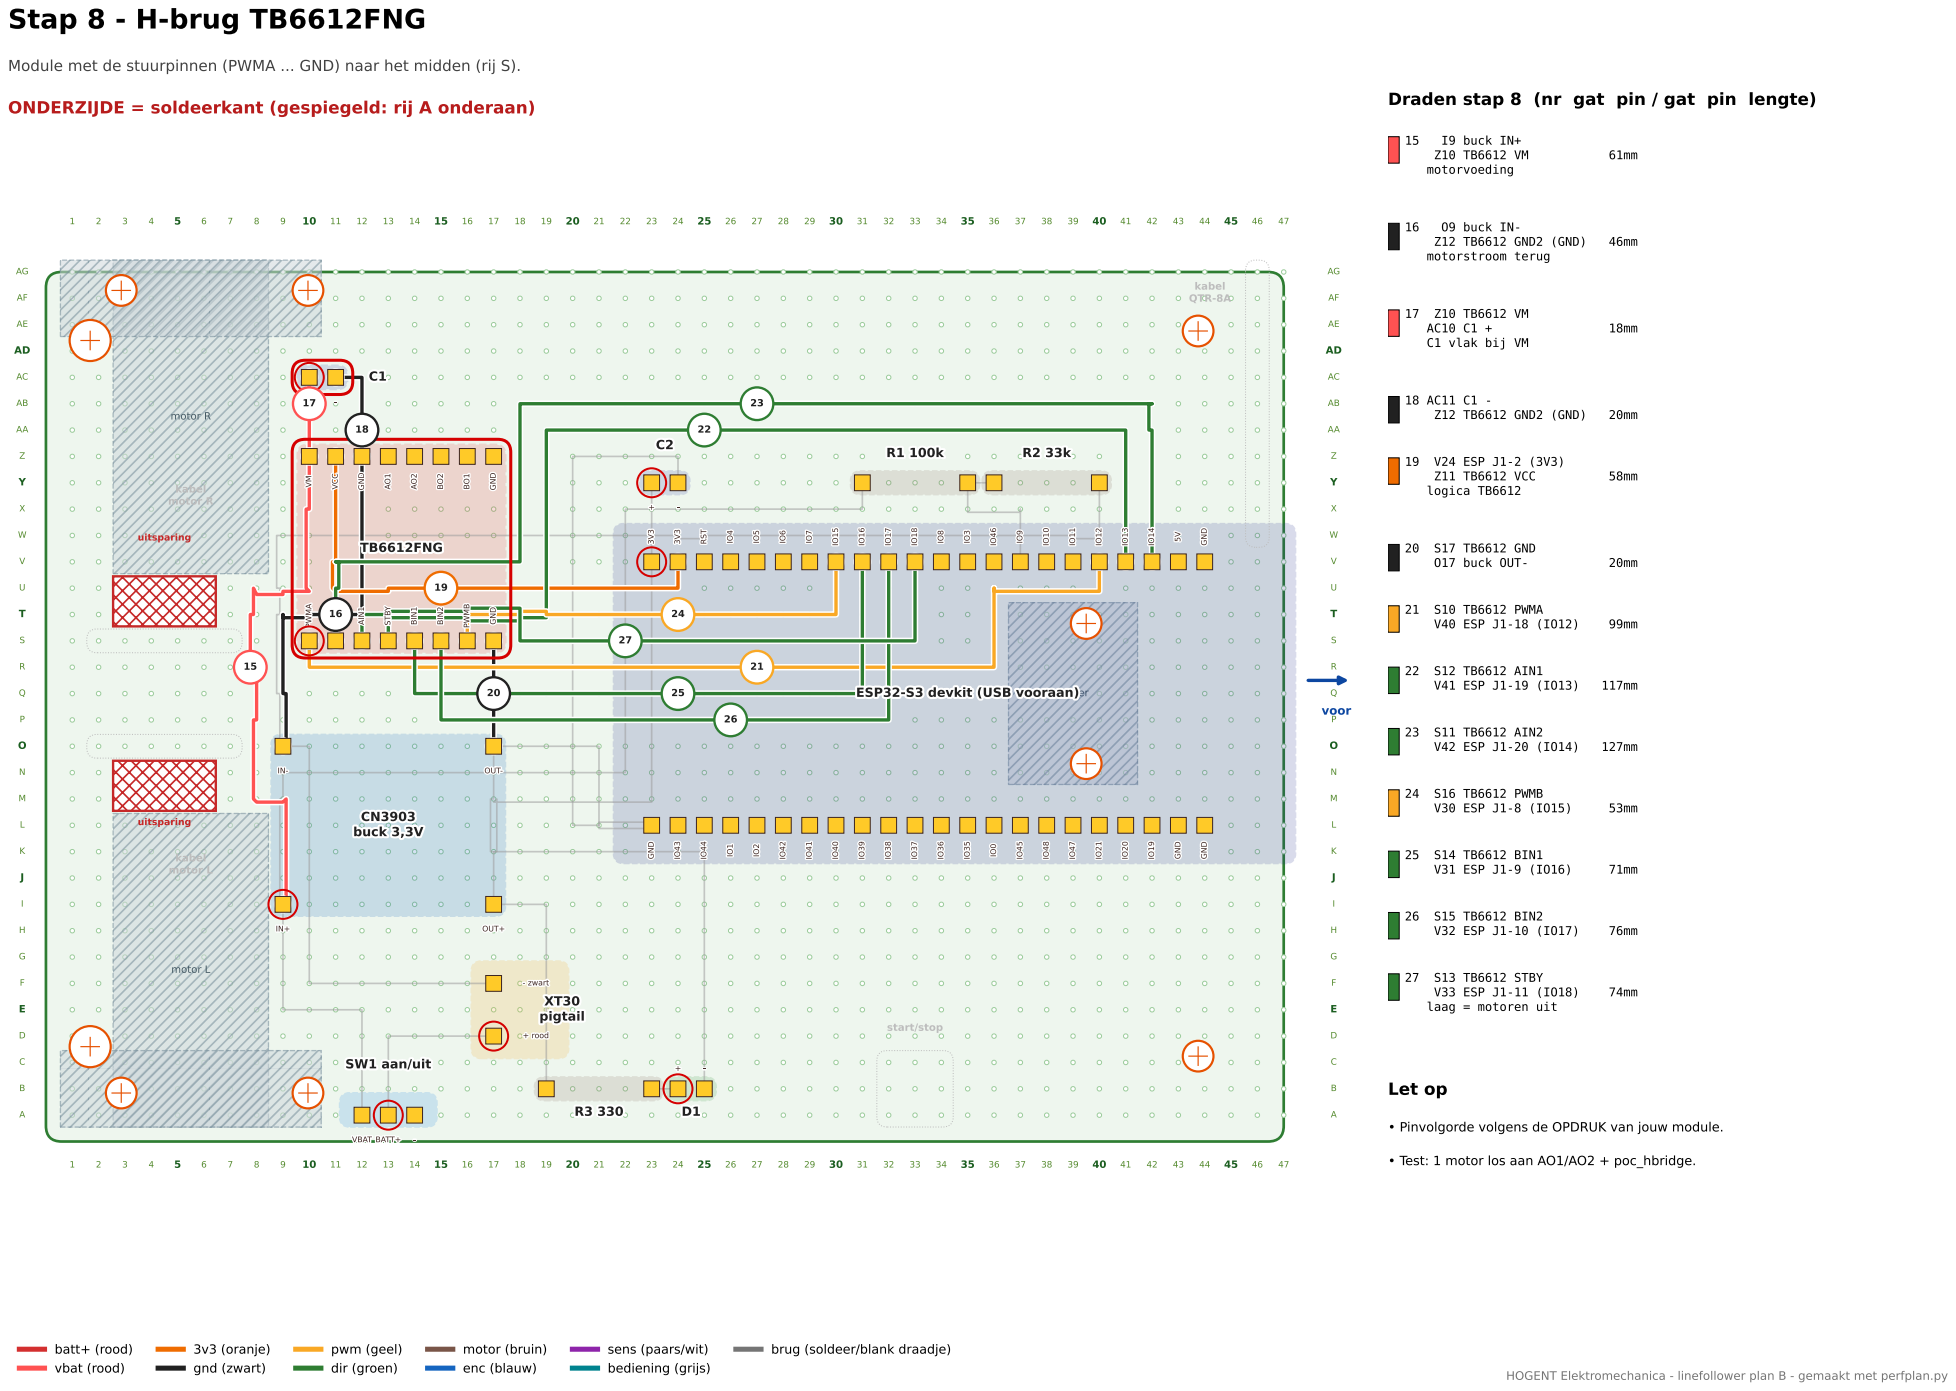
[picture p41: page 5]
motor L; motor R; caster; voor; uitsparing; kabel motor L; kabel motor R; kabel QTR-8A; start/stop; I9 buck IN+; motorvoeding; O9 buck IN-; Z12 TB6612 GND2 (GND); motorstroom terug; V24 ESP J1-2 (3V3); Z11 TB6612 VCC; logica TB6612; S17 TB6612 GND; O17 buck OUT-; S10 TB6612 PWMA; V40 ESP J1-18 (IO12); S12 TB6612 AIN1; V41 ESP J1-19 (IO13); S11 TB6612 AIN2; V42 ESP J1-20 (IO14); S16 TB6612 PWMB; V30 ESP J1-8 (IO15); S14 TB6612 BIN1; V31 ESP J1-9 (IO16); S15 TB6612 BIN2; V32 ESP J1-10 (IO17)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

Module met de stuurpinnen (PWMA ... GND) naar het midden (rij S).

ONDERZIJDE = soldeerkant (gespiegeld: rij A onderaan)

C1 vlak bij VM

laag = motoren uit

• Pinvolgorde volgens de OPDRUK van jouw module.

• Test: 1 motor los aan AO1/AO2 + poc_hbridge.

## Draden stap 9 (nr gat pin / gat pin lengte)

# Stap 9 - motoren en encoders

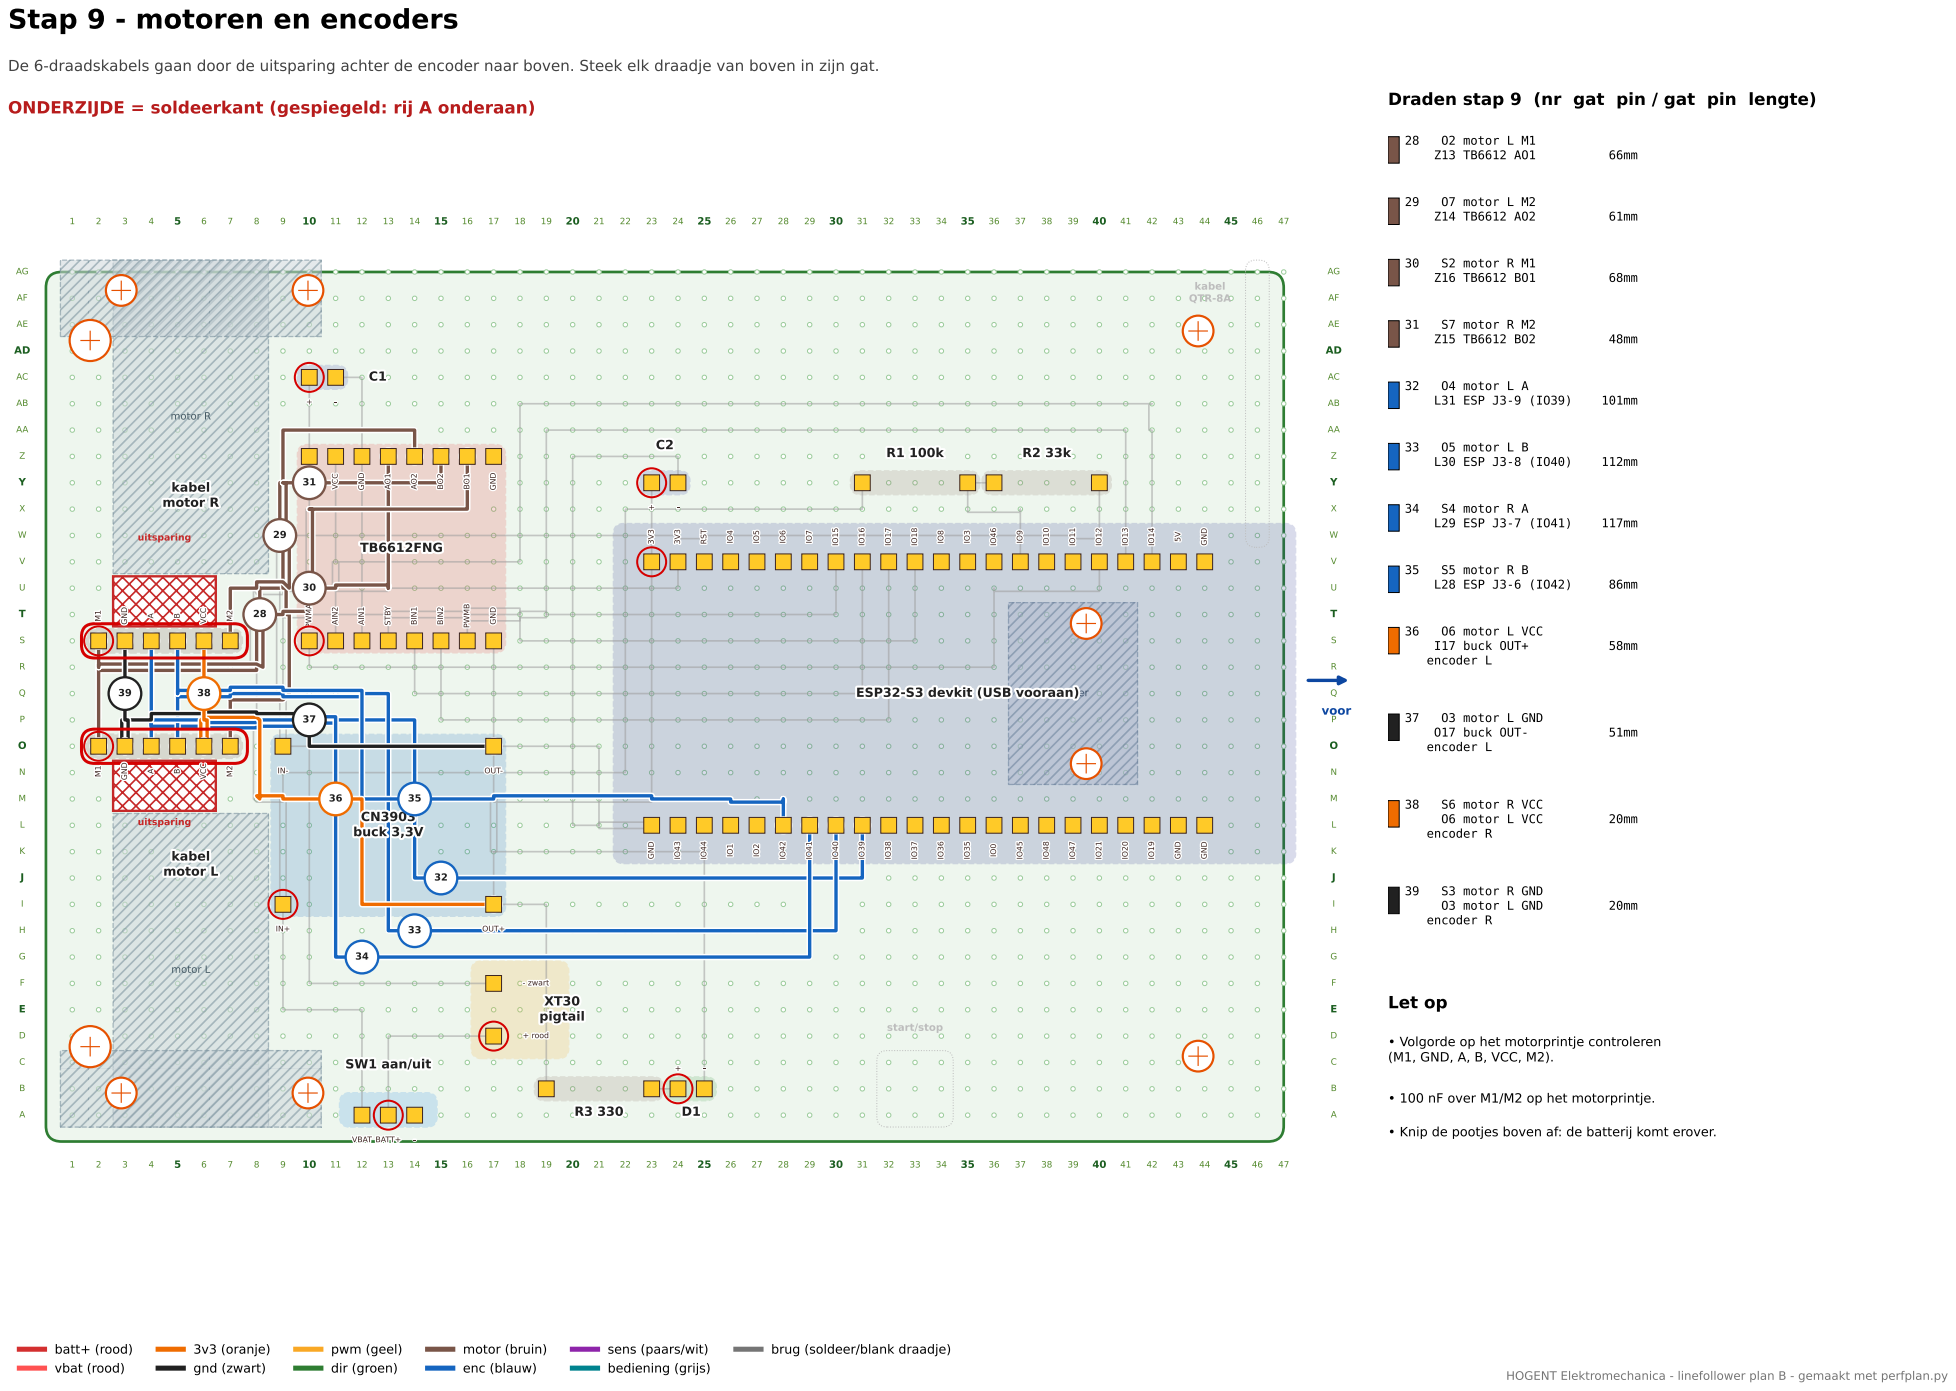
[picture p42: page 6]
motor L; motor R; caster; voor; uitsparing; kabel QTR-8A; start/stop; O2 motor L M1; O7 motor L M2; S2 motor R M1; S7 motor R M2; O4 motor L A; L31 ESP J3-9 (IO39); O5 motor L B; L30 ESP J3-8 (IO40); S4 motor R A; L29 ESP J3-7 (IO41); S5 motor R B; L28 ESP J3-6 (IO42); O6 motor L VCC; I17 buck OUT+; encoder L; O3 motor L GND; O17 buck OUT-; S6 motor R VCC; encoder R; S3 motor R GND; Let op

De 6-draadskabels gaan door de uitsparing achter de encoder naar boven. Steek elk draadje van boven in zijn gat.

ONDERZIJDE = soldeerkant (gespiegeld: rij A onderaan)

• Volgorde op het motorprintje controleren
(M1, GND, A, B, VCC, M2).

• 100 nF over M1/M2 op het motorprintje.

• Knip de pootjes boven af: de batterij komt erover.

## Draden stap 10 (nr gat pin / gat pin lengte)

# Stap 10 - sensor QTR-8A

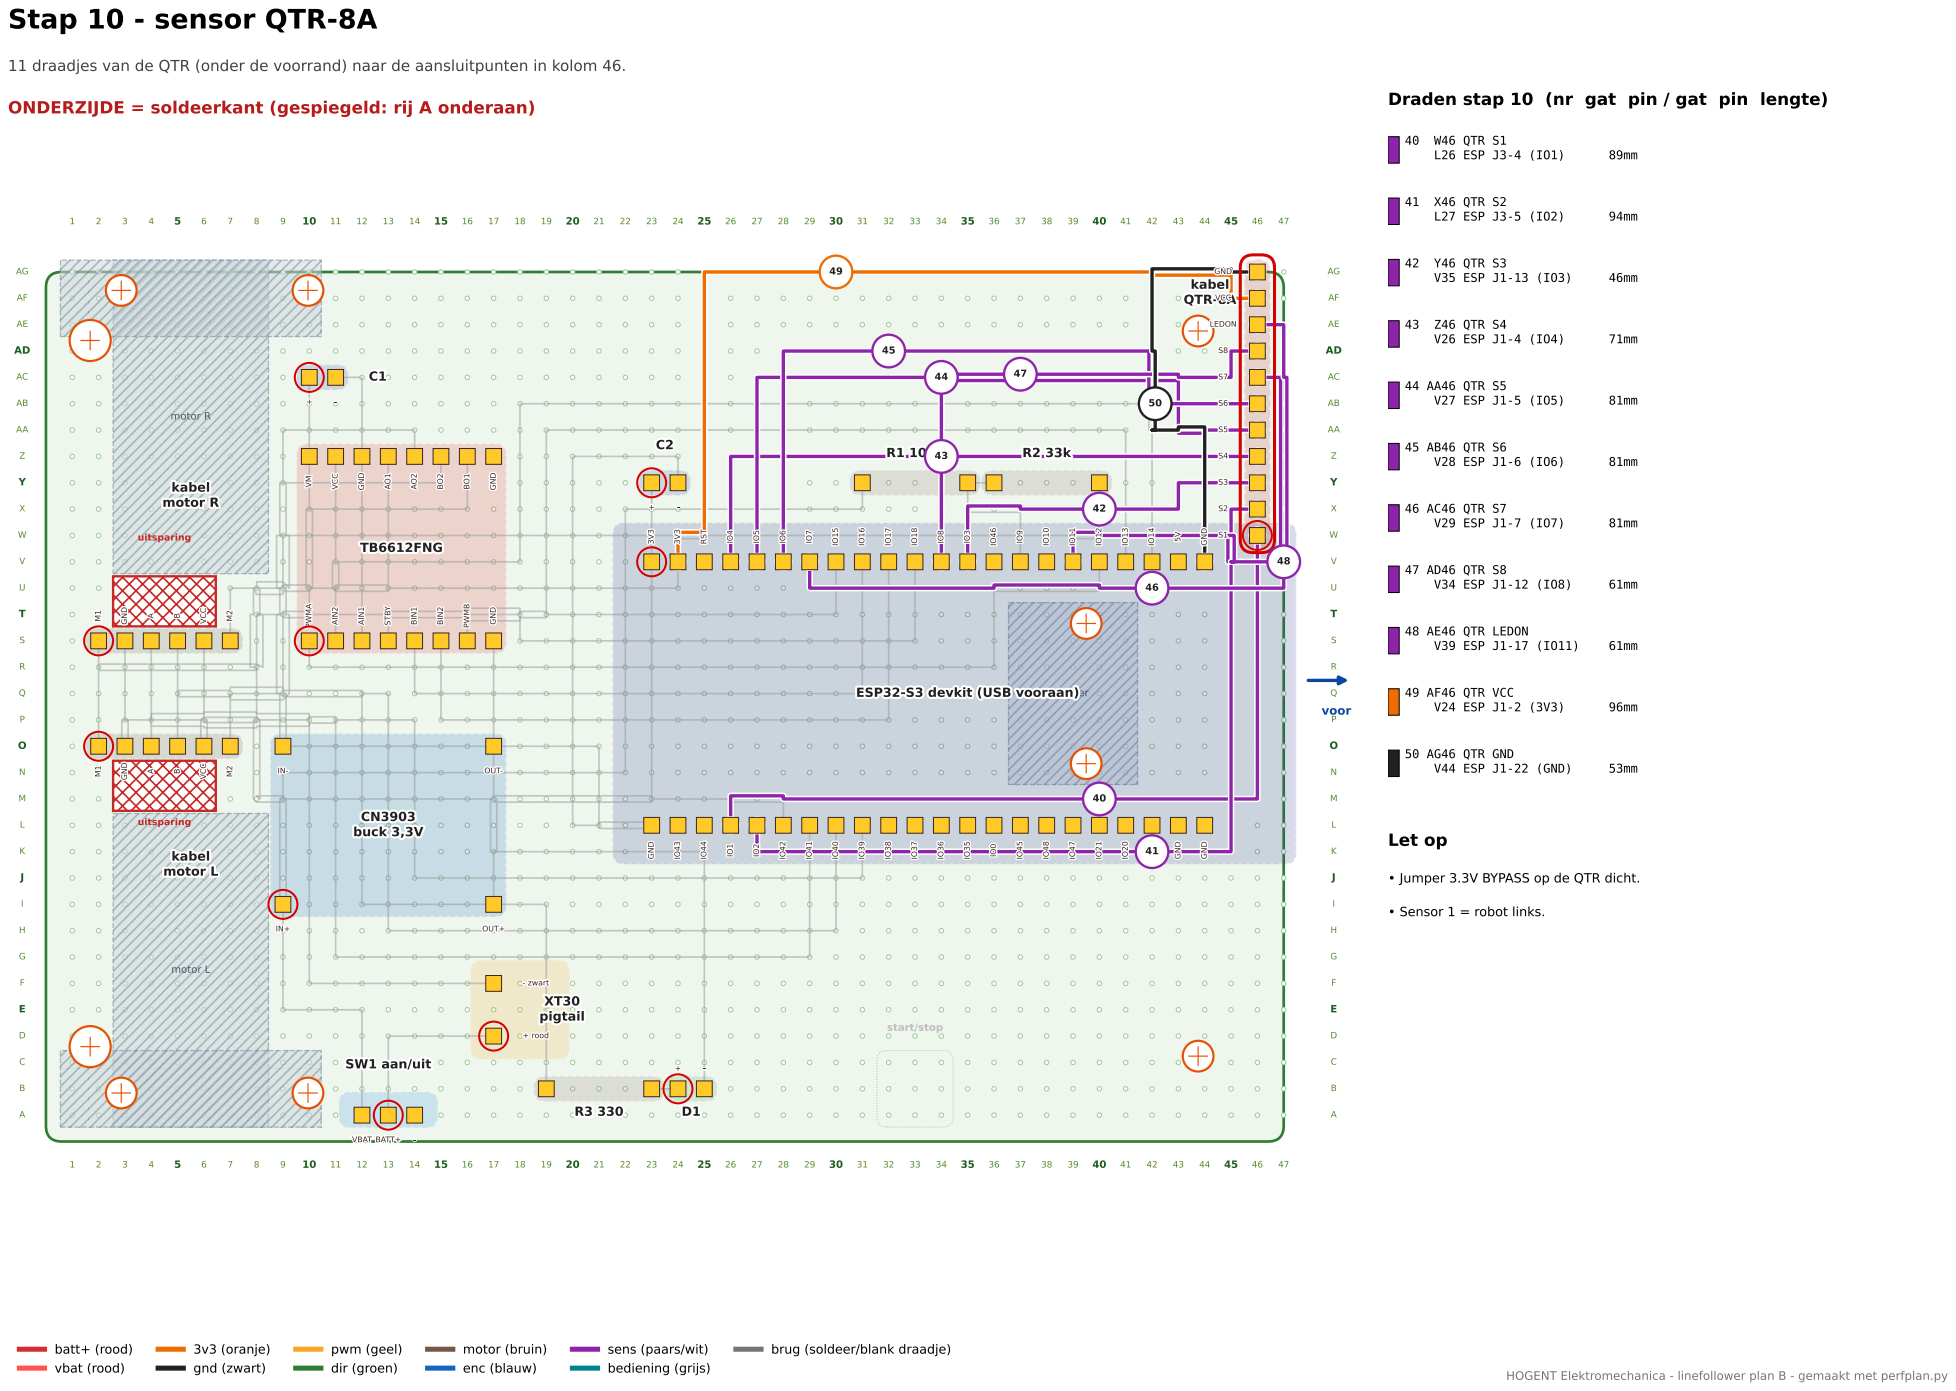
[picture p43: page 7]
motor L; motor R; caster; voor; uitsparing; start/stop; W46 QTR S1; L26 ESP J3-4 (IO1); X46 QTR S2; L27 ESP J3-5 (IO2); Y46 QTR S3; V35 ESP J1-13 (IO3); Z46 QTR S4; V26 ESP J1-4 (IO4); 44 AA46 QTR S5; V27 ESP J1-5 (IO5); 45 AB46 QTR S6; V28 ESP J1-6 (IO6); 46 AC46 QTR S7; V29 ESP J1-7 (IO7); 47 AD46 QTR S8; V34 ESP J1-12 (IO8); 48 AE46 QTR LEDON; V39 ESP J1-17 (IO11); 49 AF46 QTR VCC; V24 ESP J1-2 (3V3); 50 AG46 QTR GND; V44 ESP J1-22 (GND); Let op

11 draadjes van de QTR (onder de voorrand) naar de aansluitpunten in kolom 46.

ONDERZIJDE = soldeerkant (gespiegeld: rij A onderaan)

• Jumper 3.3V BYPASS op de QTR dicht.

• Sensor 1 = robot links.

## Draden stap 11 (nr gat pin / gat pin lengte)

## Let op

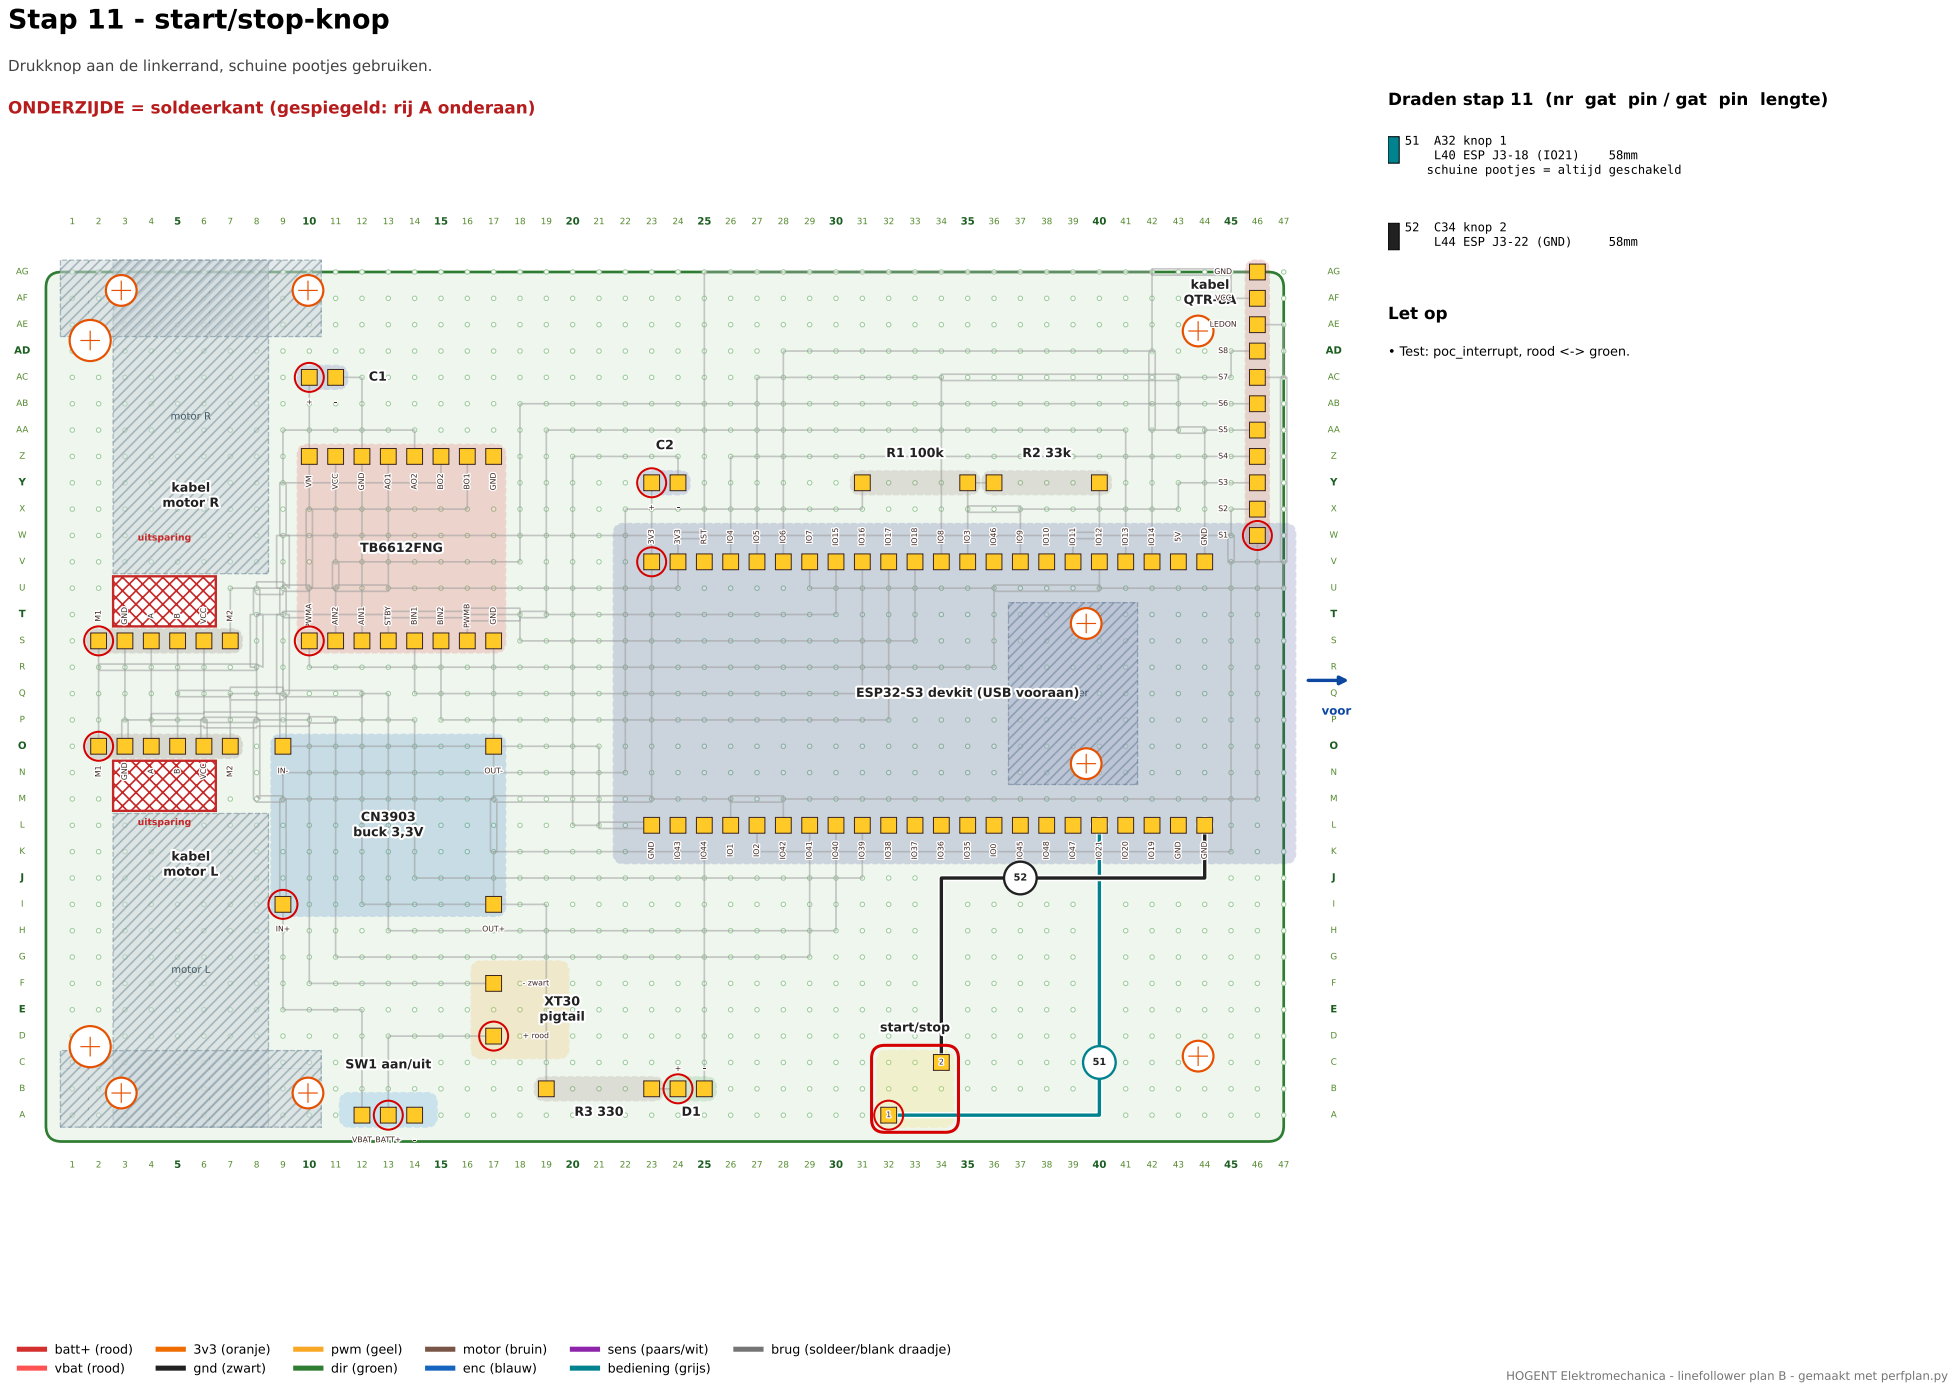
[picture p44: page 8]
motor L; motor R; caster; voor; uitsparing; A32 knop 1; L40 ESP J3-18 (IO21); C34 knop 2; L44 ESP J3-22 (GND)

Stap 11 - start/stop-knop

Drukknop aan de linkerrand, schuine pootjes gebruiken.

ONDERZIJDE = soldeerkant (gespiegeld: rij A onderaan)

schuine pootjes = altijd geschakeld

• Test: poc_interrupt, rood <-> groen.

# Linefollower - gaatjesprint - alle draden

## ONDERZIJDE = soldeerkant (gespiegeld: rij A onderaan)

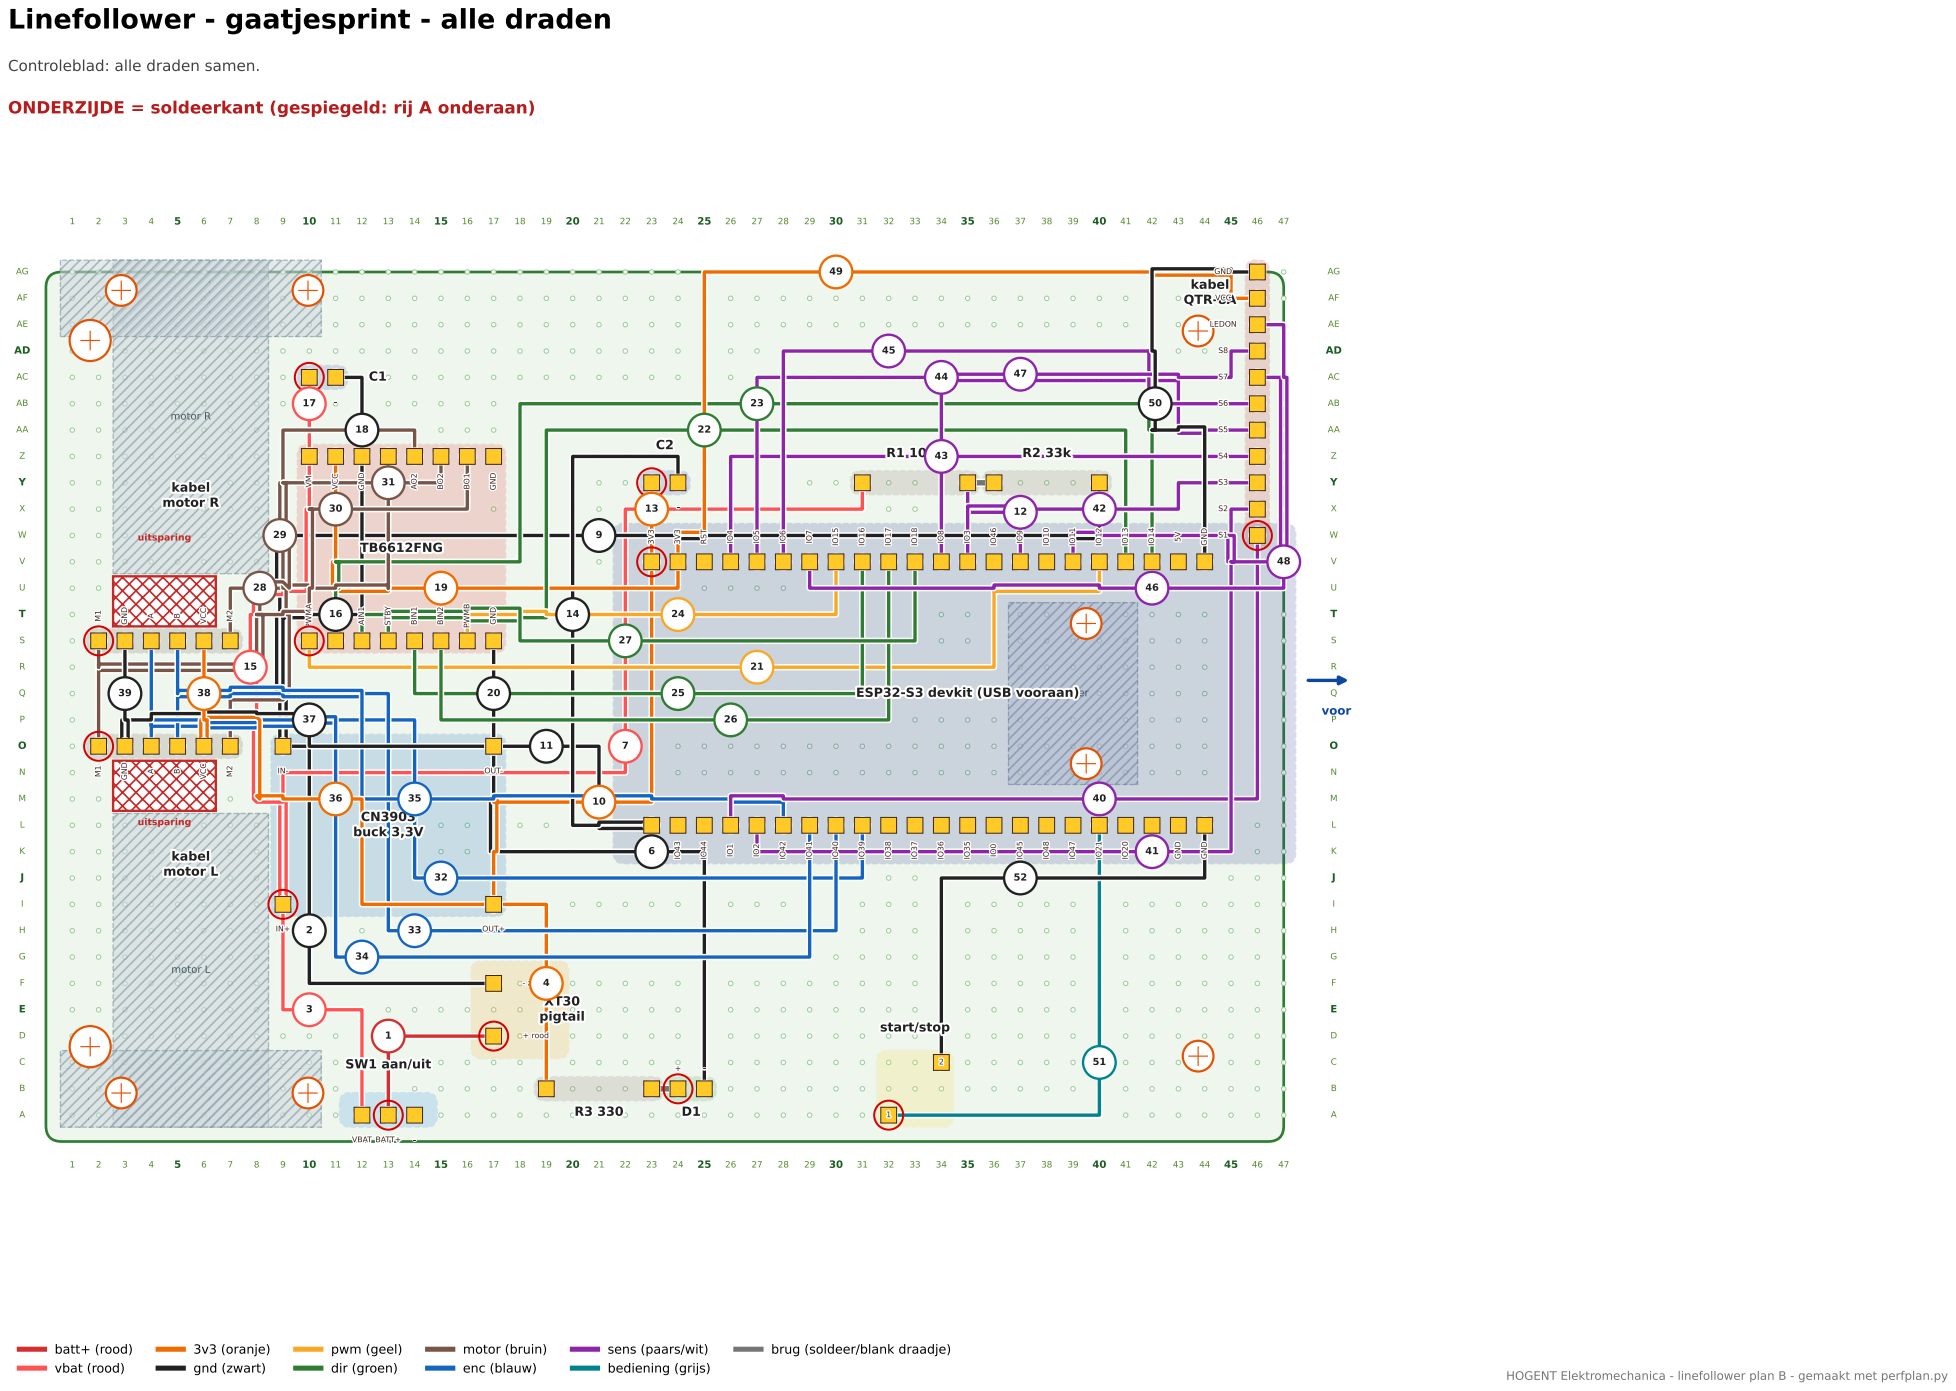
[picture p45: page 9]
motor L; motor R; caster; voor; uitsparing

Controleblad: alle draden samen.
