albinCuriel/LineFollower/technische tekeningen/elektronisch/bekabelingsplan_boormal_1op1.pdf

# Linefollower - gaatjesprint - BOORMAL 1:1 (afdrukken op 100 %, bovenzijde)

Controle: 10 gaten = 25.4 mm. Oranje kruis = boren, rode cirkel = pin 1.

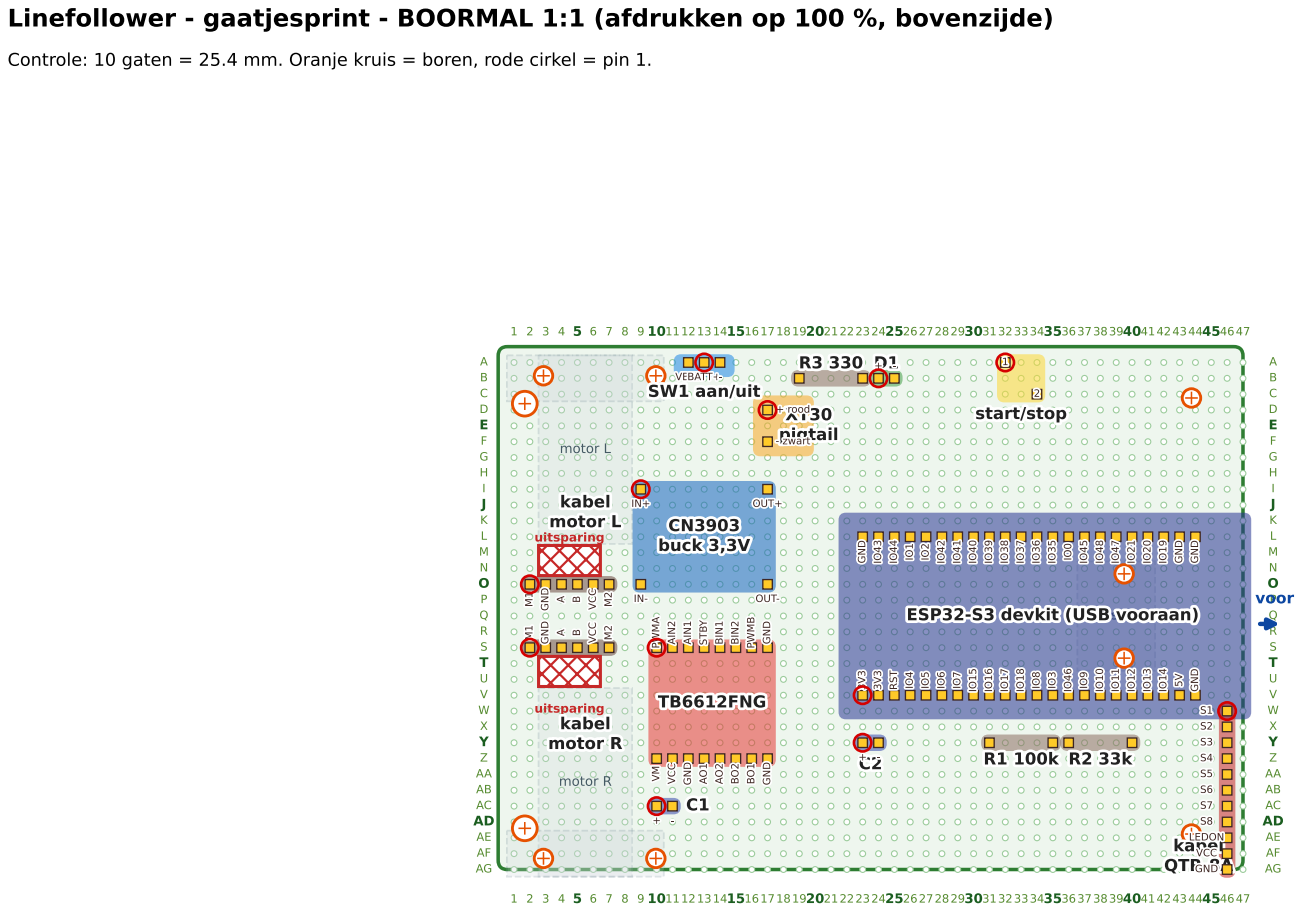
[picture p46: page 1]
motor L; motor R; caster; voor; uitsparing
