albinCuriel/LineFollower/technische tekeningen/mechanisch/tekening_linefollower.pdf

## BOVENAANZICHT 1:1

## ISOMETRIE (niet op schaal)

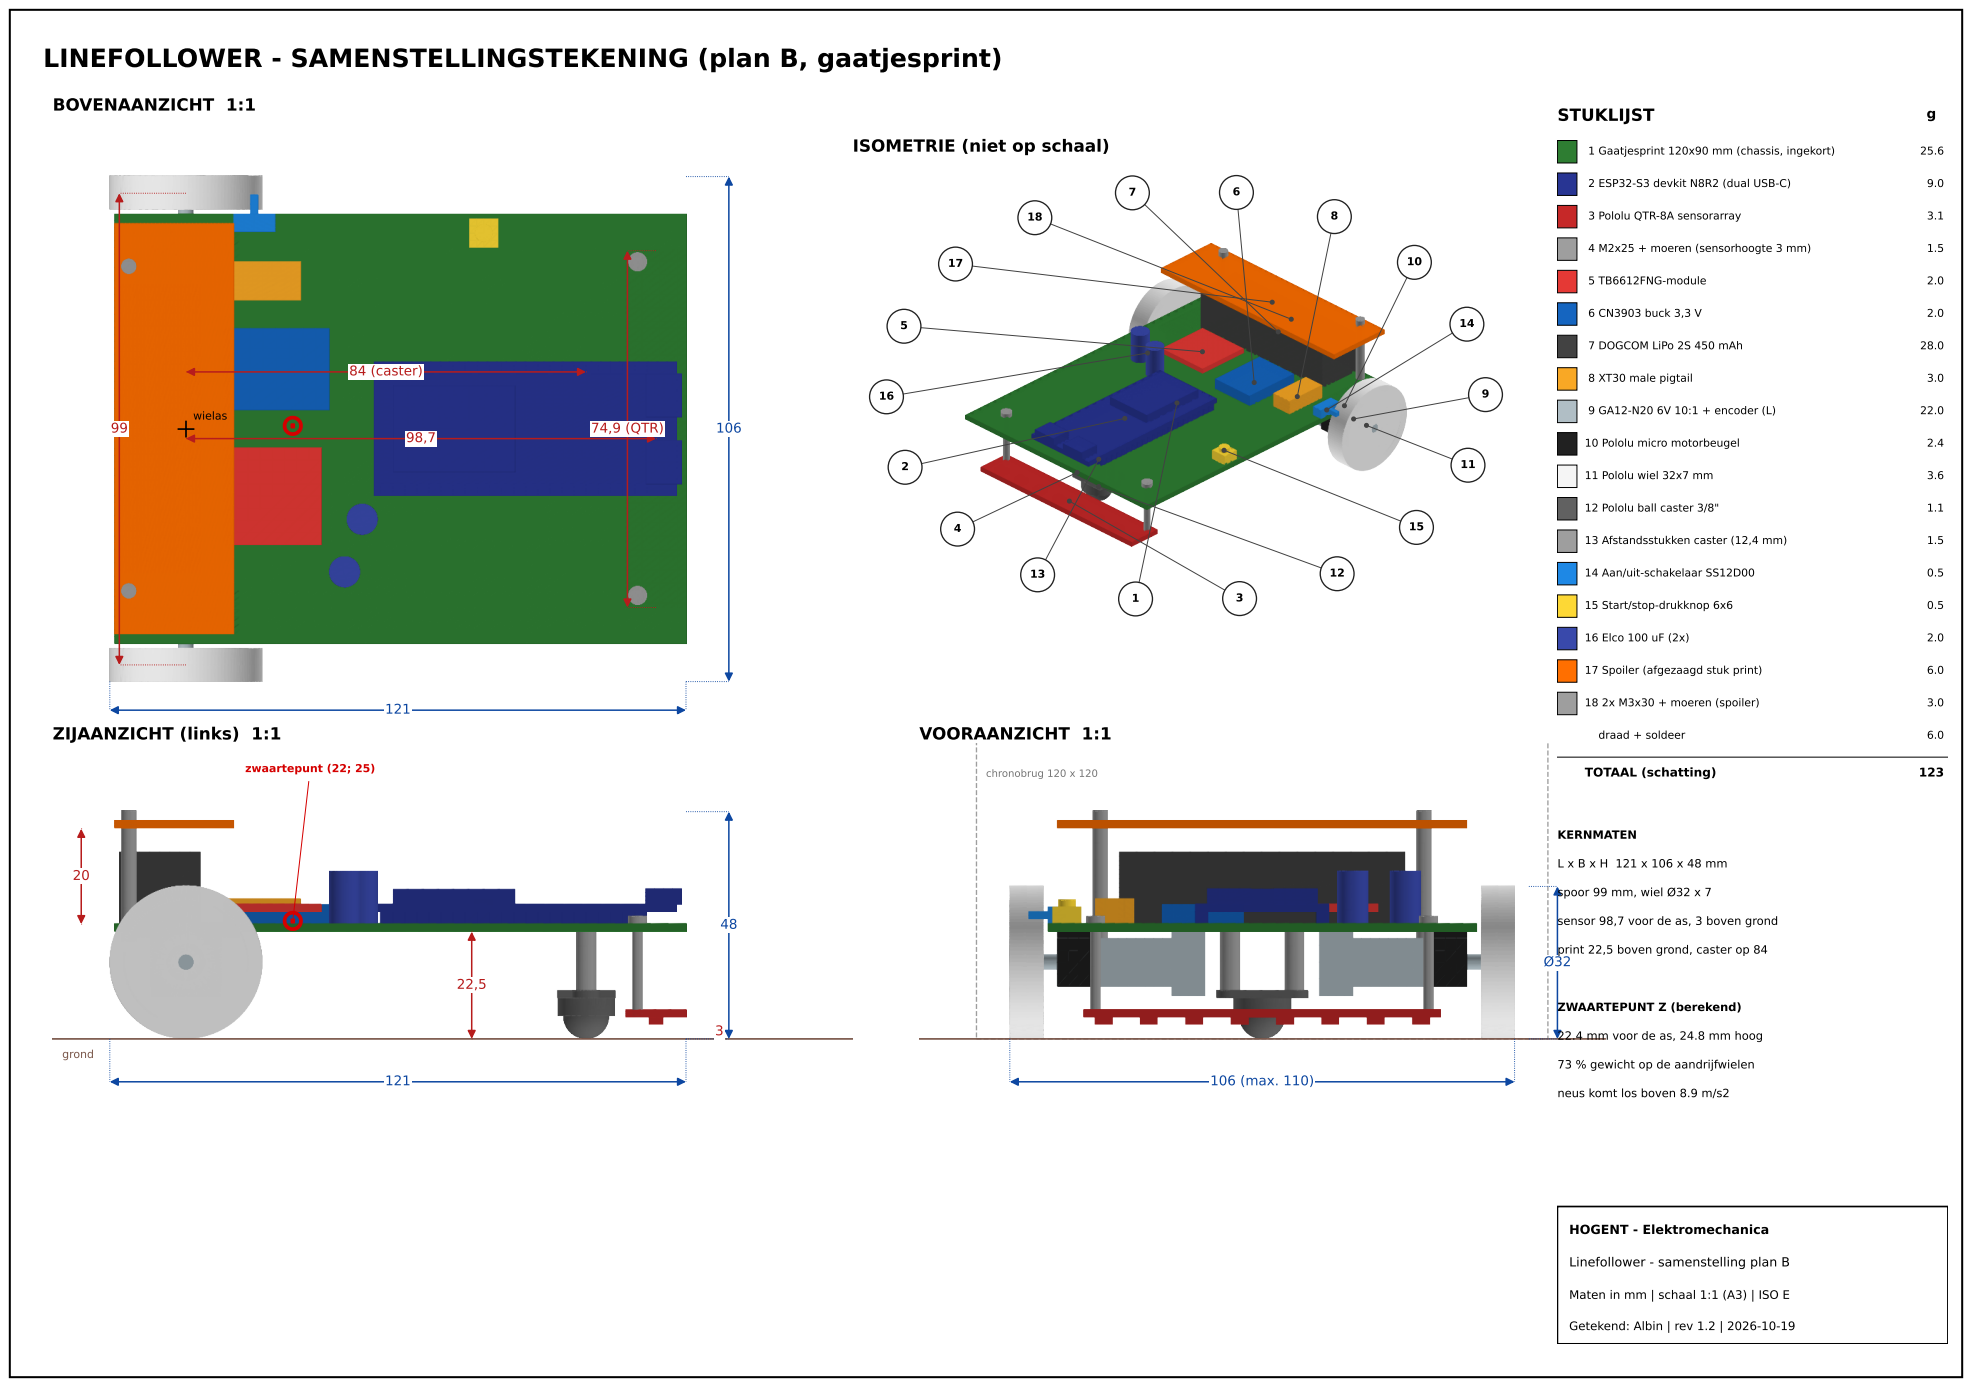
[picture p47: page 1]
84 (caster); 74,9 (QTR); wielas; ZIJAANZICHT (links) 1:1; grond; zwaartepunt (22; 25); VOORAANZICHT 1:1; 106 (max. 110); chronobrug 120 x 120; STUKLIJST; 1 Gaatjesprint 120x90 mm (chassis, ingekort); 2 ESP32-S3 devkit N8R2 (dual USB-C); 3 Pololu QTR-8A sensorarray; 4 M2x25 + moeren (sensorhoogte 3 mm); 5 TB6612FNG-module; 6 CN3903 buck 3,3 V; 7 DOGCOM LiPo 2S 450 mAh; 8 XT30 male pigtail; 9 GA12-N20 6V 10:1 + encoder (L); 10 Pololu micro motorbeugel; 11 Pololu wiel 32x7 mm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

LINEFOLLOWER - SAMENSTELLINGSTEKENING (plan B, gaatjesprint)

spoor 99 mm, wiel Ø32 x 7

sensor 98,7 voor de as, 3 boven grond

print 22,5 boven grond, caster op 84

22.4 mm voor de as, 24.8 mm hoog

73 % gewicht op de aandrijfwielen

neus komt los boven 8.9 m/s2

Linefollower - samenstelling plan B

Maten in mm | schaal 1:1 (A3) | ISO E

Getekend: Albin | rev 1.2 | 2026-10-19
