albinCuriel/LineFollower/technische tekeningen/elektronisch/kicad/linefollower.kicad_sch

## KiCad design technische tekeningen/elektronisch/kicad/linefollower.kicad_sch (2026-10-19, an earlier design)

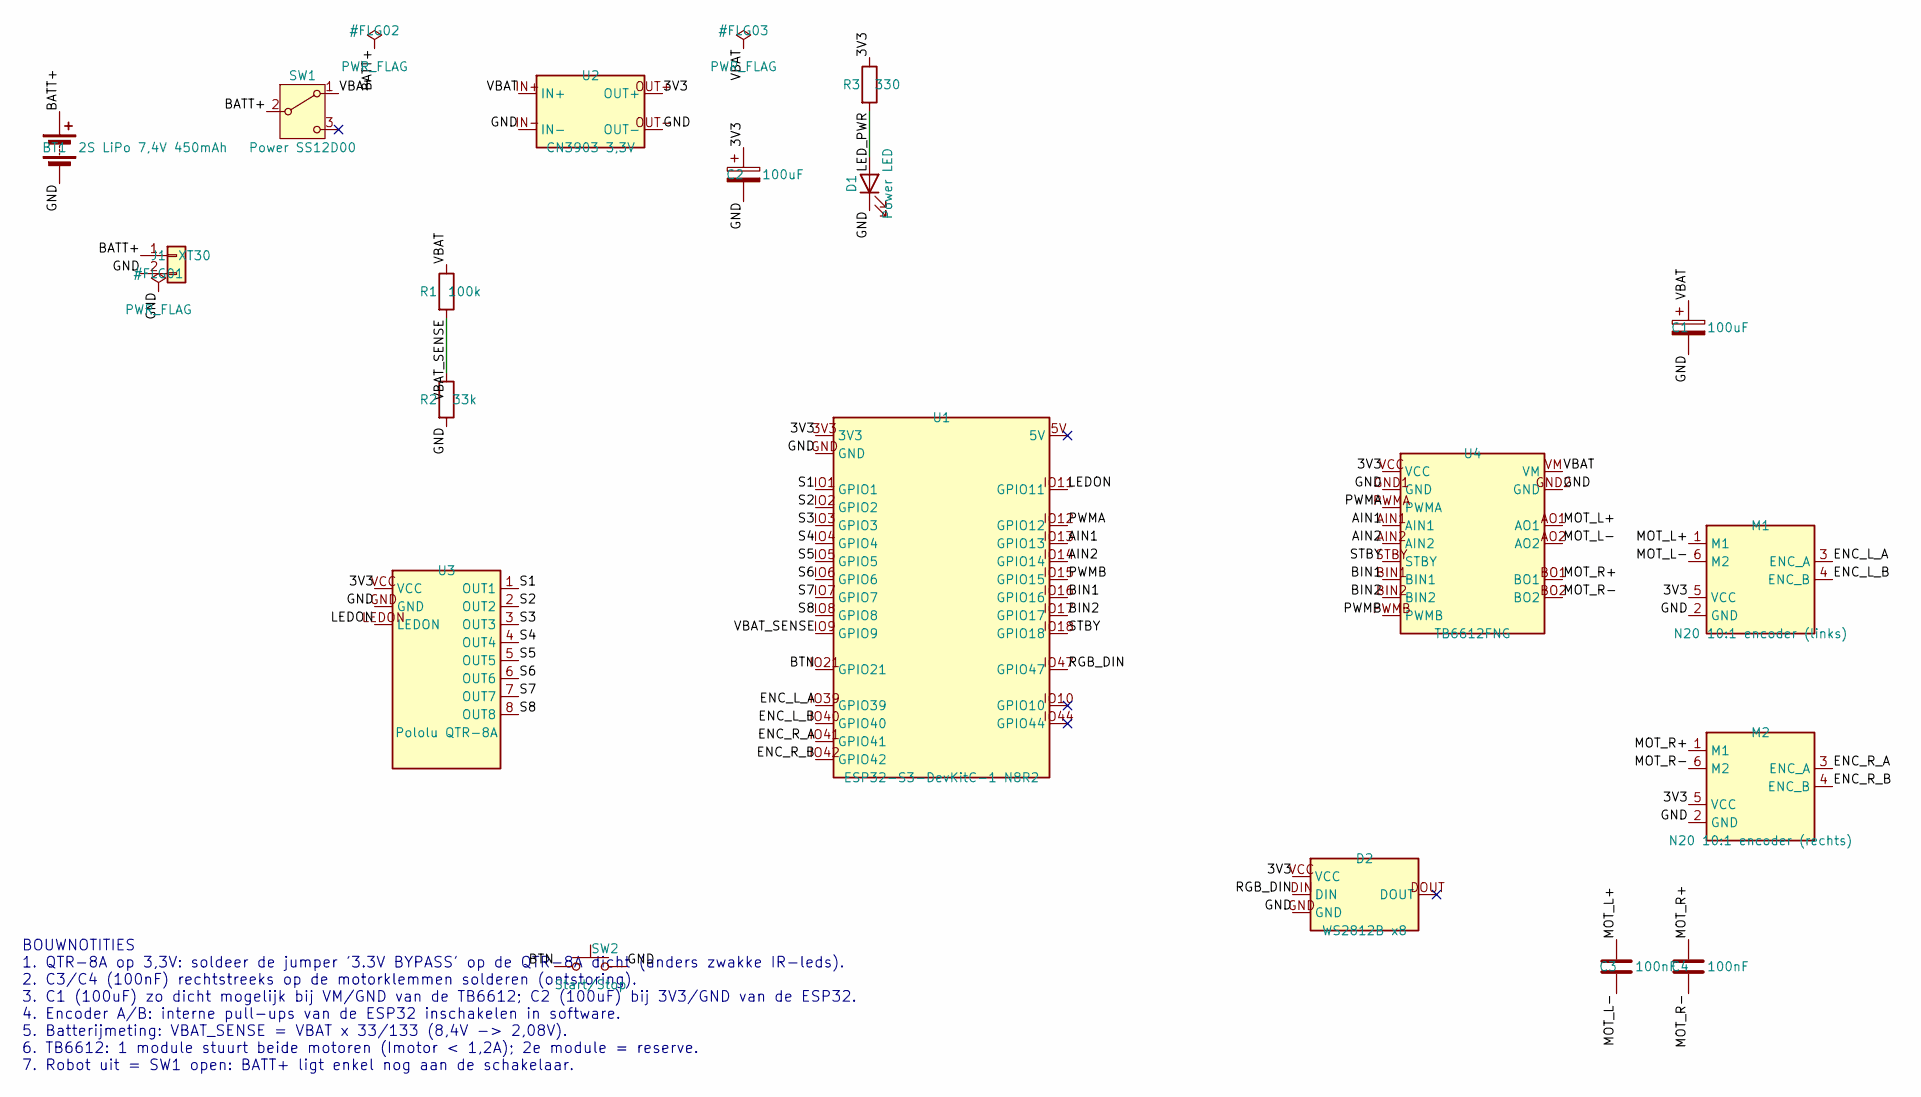
[picture p49: schematic linefollower.kicad_sch]

Parts:
BT1: 2S LiPo 7,4V 450mAh
C1, C2: 100uF
C3, C4: 100nF
D1: Power LED
D2: WS2812B x8
J1: XT30
M1: N20 10:1 encoder (links)
M2: N20 10:1 encoder (rechts)
R1: 100k
R2: 33k
R3: 330
SW1: Power SS12D00
SW2: Start/Stop
U1: ESP32-S3-DevKitC-1 N8R2
U2: CN3903 3,3V
U3: Pololu QTR-8A
U4: TB6612FNG

Connections:
3V3: C2.1, D2.VCC, M1.5 (VCC), M2.5 (VCC), R3.1, U1.3V3, U2.OUT+, U3.VCC, U4.VCC
AIN1: U1.IO13 (GPIO13), U4.AIN1
AIN2: U1.IO14 (GPIO14), U4.AIN2
BATT+: BT1.1 (+), J1.1, SW1.2 (B)
BIN1: U1.IO16 (GPIO16), U4.BIN1
BIN2: U1.IO17 (GPIO17), U4.BIN2
BTN: SW2.1, U1.IO21 (GPIO21)
ENC_L_A: M1.3 (ENC_A), U1.IO39 (GPIO39)
ENC_L_B: M1.4 (ENC_B), U1.IO40 (GPIO40)
ENC_R_A: M2.3 (ENC_A), U1.IO41 (GPIO41)
ENC_R_B: M2.4 (ENC_B), U1.IO42 (GPIO42)
GND: BT1.2 (-), C1.2, C2.2, D1.1 (K), D2.GND, J1.2, M1.2 (GND), M2.2 (GND), R2.2, SW2.2, U1.GND, U2.IN-, U2.OUT-, U3.GND, U4.GND1 (GND), U4.GND2 (GND)
LEDON: U1.IO11 (GPIO11), U3.LEDON
LED_PWR: D1.2 (A), R3.2
MOT_L+: C3.1, M1.1 (M1), U4.AO1
MOT_L-: C3.2, M1.6 (M2), U4.AO2
MOT_R+: C4.1, M2.1 (M1), U4.BO1
MOT_R-: C4.2, M2.6 (M2), U4.BO2
PWMA: U1.IO12 (GPIO12), U4.PWMA
PWMB: U1.IO15 (GPIO15), U4.PWMB
RGB_DIN: D2.DIN, U1.IO47 (GPIO47)
S1: U1.IO1 (GPIO1), U3.1 (OUT1)
S2: U1.IO2 (GPIO2), U3.2 (OUT2)
S3: U1.IO3 (GPIO3), U3.3 (OUT3)
S4: U1.IO4 (GPIO4), U3.4 (OUT4)
S5: U1.IO5 (GPIO5), U3.5 (OUT5)
S6: U1.IO6 (GPIO6), U3.6 (OUT6)
S7: U1.IO7 (GPIO7), U3.7 (OUT7)
S8: U1.IO8 (GPIO8), U3.8 (OUT8)
STBY: U1.IO18 (GPIO18), U4.STBY
VBAT: C1.1, R1.1, SW1.1 (A), U2.IN+, U4.VM
VBAT_SENSE: R1.2, R2.1, U1.IO9 (GPIO9)

Notes on the sheet:
BOUWNOTITIES 1. QTR-8A op 3,3V: soldeer de jumper '3.3V BYPASS' op de QTR-8A dicht (anders zwakke IR-leds). 2. C3/C4 (100nF) rechtstreeks op de motorklemmen solderen (ontstoring). 3. C1 (100uF) zo dicht mogelijk bij VM/GND van de TB6612; C2 (100uF) bij 3V3/GND van de ESP32. 4. Encoder A/B: interne 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
