albinCuriel/LineFollower/(commit log)

2026-10-19 Ontwerpkeuzes en BOM: ESP32-S3, onderdelenanalyse en definitieve bestelling
    Onderdelenkeuze met analyse vorige jaren, parcourssimulatie en verantwoording
    afwijking van KISS (ESP32-S3 i.p.v. ATmega32U4, backup = 32U4). BOM bijgewerkt
    naar de werkelijke bestelling van 19/10/2026.
2026-10-19 Technische tekeningen: KiCad-schema, bedradingslijst en 3D-model
    Elektrisch schema in KiCad (eigen symbolen, ERC 0 fouten) met PDF-export en
    pin-naar-pin bedradingslijst. 3D-model (STL + STEP) en tekenblad met 4 aanzichten.
    [ESP32-S3_devkit.stl, LiPo_2S_450mAh.stl, M2_bevestiging_sensor.stl, QTR-8A.stl, TB6612FNG.stl, WS2812_8leds.stl, XT30.stl, aan_uit_schakelaar.stl]
2026-10-19 Code: board.h pinmap en 4 proof of concepts voor ESP32-S3
    PoC's voor sensor (QTR-8A met LEDON), H-brug, drukknop-interrupt en wifi-duplex.
    Alle sketches compileren voor esp32:esp32:esp32s3.
2026-10-19 BOM: sectie 'bewust niet besteld' verwijderd
2026-10-19 Tekeningen naar echte onderdelen, bekabelingsplan, bouwplan en readme per map
    - Elektrisch schema rev 1.1: WS2812 weg (niet besteld), status via ingebouwde RGB-led (GPIO48), waarden = bestelde onderdelen, PDF + SVG
    - 3D-model parametrisch (model_linefollower.py): Pololu-maten uit de maattekeningen, AliExpress-maten na te meten; print ingekort tot 120 mm, spoiler uit het afgezaagde stuk
    - Boormal 1:1, bekabelingsplan 2:1 met 48 genummerde draden en draadlijst per bouwstap (bekabelingsplan.py)
    - Instructable: 13 stappen met test per stap
    - Readme in elke map, gebruiksaanwijzing, datasheets, PoC-uitleg
    - Tekenscript 30x sneller, PDF 13 MB -> 0,2 MB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
    [ESP32-S3_devkit.stl, LiPo_2S_450mAh.stl, M2_bevestiging_sensor.stl, QTR-8A.stl, TB6612FNG.stl, WS2812_8leds.stl, XT30.stl, aan_uit_schakelaar.stl]
2026-10-19 Renders opnieuw met het snelle tekenscript
2026-10-19 Bekabelingsplan v2: gatcoordinaten, router, pagina per bouwstap, kabels (WireViz)
    - perfplan.py + bekabeling_config.py: elk onderdeel op het gaatjesraster (gat F22), draden automatisch
    gerouteerd door vrije gaten (A*, niet door pinnen, keep-outs of boorgaten), bundels naast elkaar getekend
    - bekabelingsplan.pdf: plaatsing + 1 A3-pagina per bouwstap + controleblad; PNG per pagina in de instructable
    - boormal 1:1 en draadlijst met gaten en lengtes (52 draden, 3,3 m totaal)
    - kabels/: batterij-, motor- en sensorkabel pin per pin (WireViz)
    - instructable stappen 4-11 herschreven op de nieuwe draadnummers
    [kabels.bom.tsv]
2026-10-19 Firmware, simulatie met de echte regelcode, tekening 1:1 en caster naar voren
    - code/lib/lf_core: portable regelkern (kalibratie, normalisatie, zwaartepunt-interpolatie, PID,
    boost/rem, PI-wielsnelheid, batterijcompensatie, set/get-commando's); 133 unit tests op de pc
    - code/lib/lf_esp32: hardwarelaag (LEDON aan/uit, PWM, PCNT-encoders, knop-ISR, wifi+USB, flash)
    - code/basis (cursus) en code/finaal (volledige firmware + testcommando's per bouwstap) compileren
    - simulatie/: robot op parcours 3 met lf_core als DLL (software-in-the-loop), parallelle tuner;
    standaardparameters = tuneresultaat (0,82 m/s, max. 3 mm afwijking, lijn nooit kwijt)
    - interpolatie parabool -> zwaartepunt (5,3 -> 1,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
    [ball_caster.stl, caster_afstandsstukken.stl, linefollower_assembly.step]
2026-11-05 Bekabelingsplan aangepast aan de echte gaatjesprint (33 x 54 gaten) + uitsparingen encoderkabels
    - print 9 x 15 cm heeft 33 rijen i.p.v. 35: alle onderdelen en boorgaten 1 rij
    opgeschoven (zelfde positie in mm), QTR-aansluiting naar W46-AG46, SW1 1 gat
    naar rechts zodat draad 3 een route vindt
    - 2 uitsparingen van 4 x 2 gaten (rij M-N en T-U, kolom 3-6) zodat de
    encoderkabels recht naar boven gaan i.p.v. onder de motor (sleepten over de
    grond); motoraansluiting naar O2-O7 en S2-S7
    - perfplan.py: UITSPARINGEN in de config (geblokkeerd voor de router, rood
    gekruist op elke pagina en op de boormal)
    - boormal, bekabelingsplan, draadlijst en kabeltekening (WireViz) opnieuw gemaakt
    - ins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
